NUbots/NUware/BackPanel/front.png

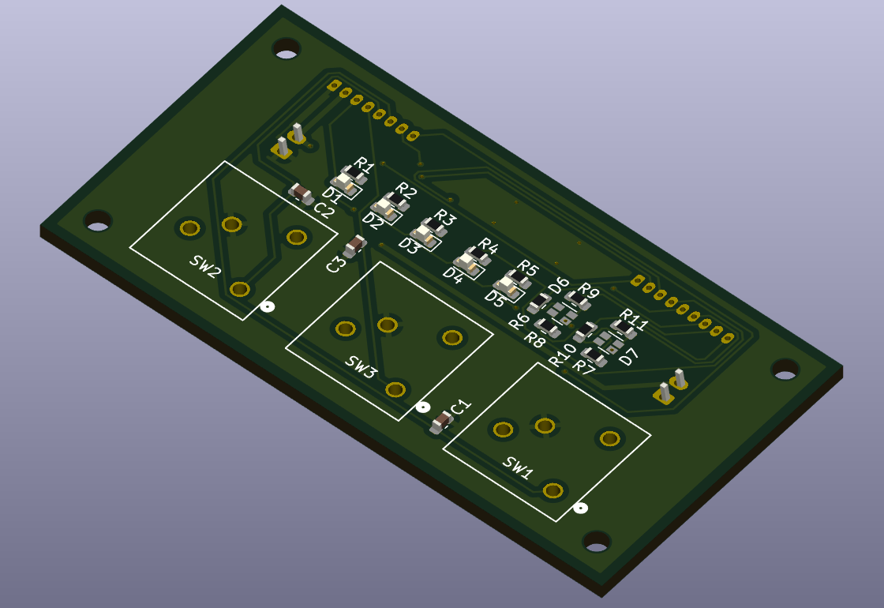
BackPanel/front.png
