NUbots/NUware/BackPanel/back.png

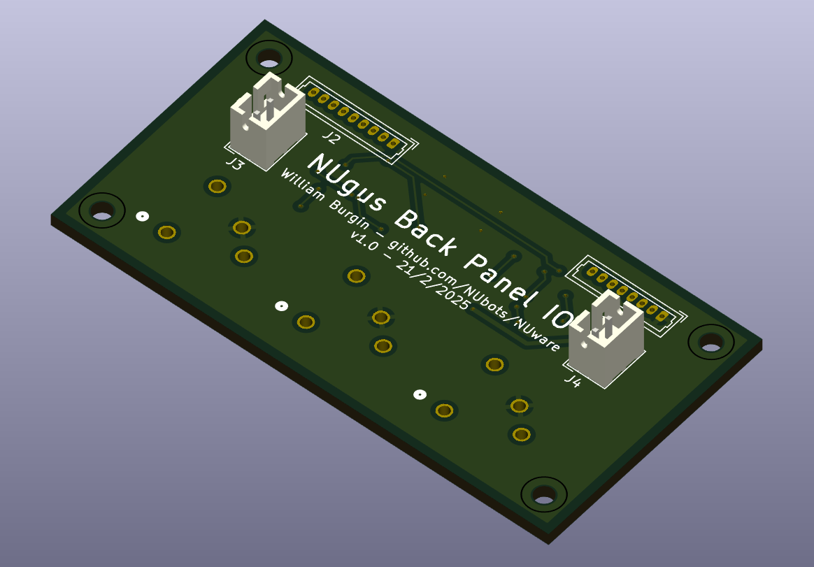
BackPanel/back.png
