NUbots/NUware/README.md

NUware
======

## Description
Hardware used by the NUbots team.
