NUbots/NUware/NUcr/NUcr.png

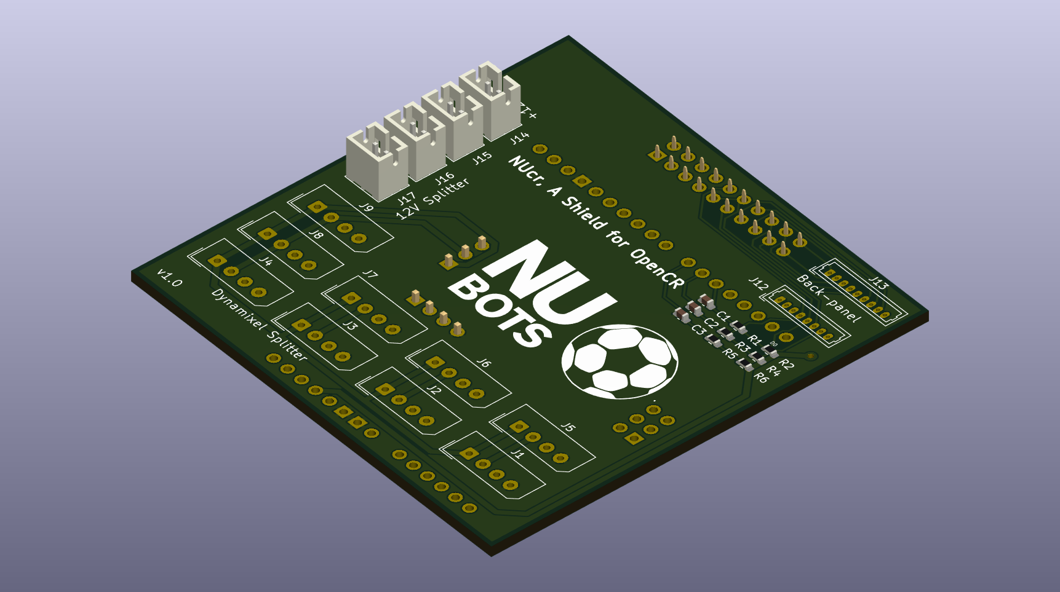
NUcr/NUcr.png
