NUbots/NUware/NUcr/resources/Ball_Black2.png

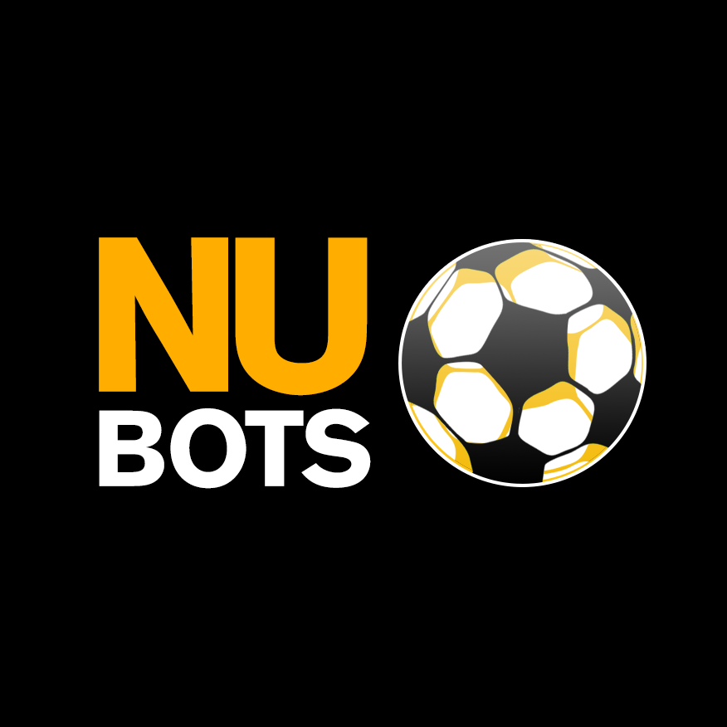
NUcr/resources/Ball_Black2.png
