NUbots/NUware/Darwin/Step Files/Darwin Foot.step

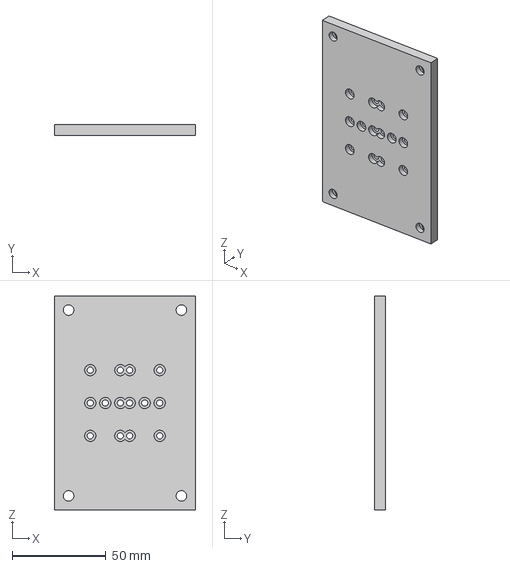
[picture p5: CAD file, 2017-06-25]
Darwin/Step Files/Darwin Foot.step
75.1 x 6.00 x 114.0 mm
