NUbots/NUware/Igus/Current Design/step_file/Flywheel_Bracket.step

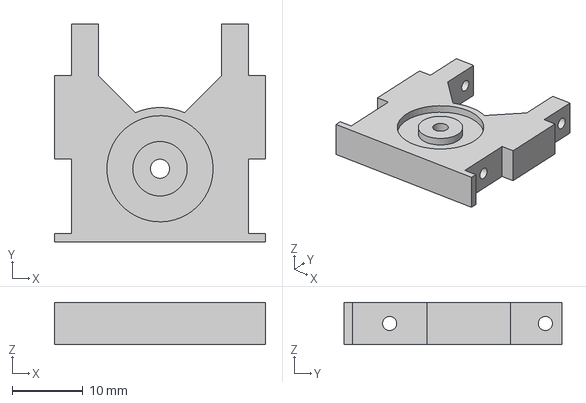
[picture p6: CAD file, 2019-11-25]
Igus/Current Design/step_file/Flywheel_Bracket.step
29.8 x 30.8 x 6.00 mm
