NUbots/NUware/Igus/Current Design/stl_file/Ankle_Block_v4/MX-106R_Ankle_Roll_Left.stl

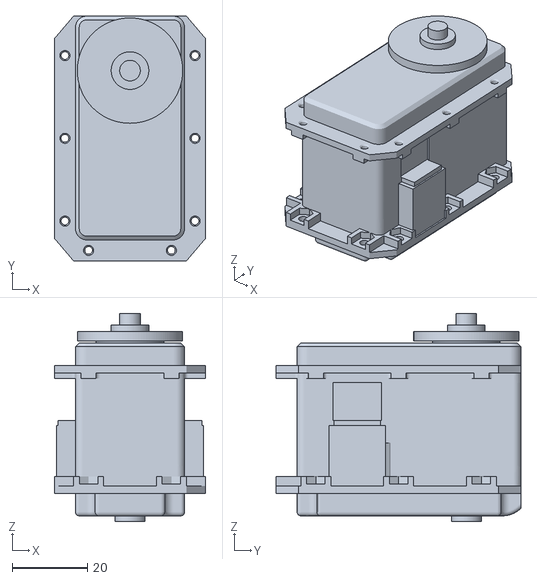
[picture p7: CAD file, 2019-04-18]
Igus/Current Design/stl_file/Ankle_Block_v4/MX-106R_Ankle_Roll_Left.stl
40.2 x 65.1 x 55.3
