NUbots/NUware/Igus/Current Design/stl_file/Arm_Lower_Left_v9/Arm_lower_bar.stl

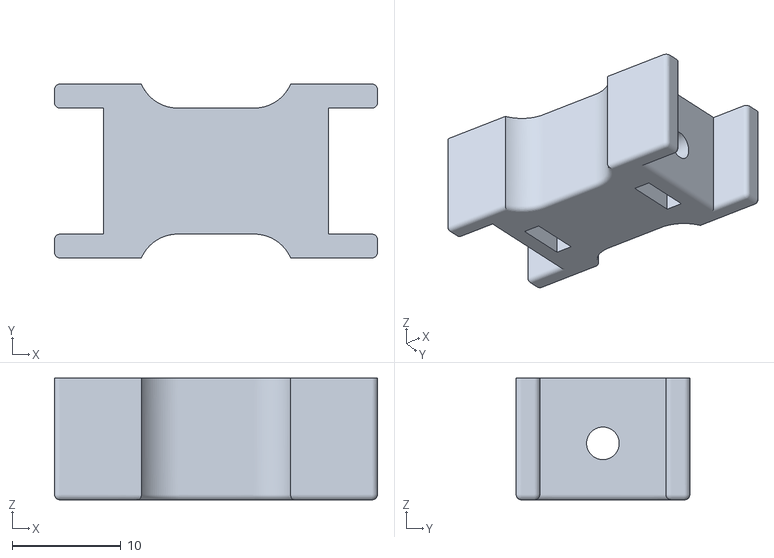
[picture p8: CAD file, 2019-04-18]
Igus/Current Design/stl_file/Arm_Lower_Left_v9/Arm_lower_bar.stl
29.7 x 16.0 x 11.2
