NUbots/NUware/Igus/Current Design/stl_file/Arm_Upper_Left_v8/MX-64AT_AR_Shoulder_Roll_Left.stl

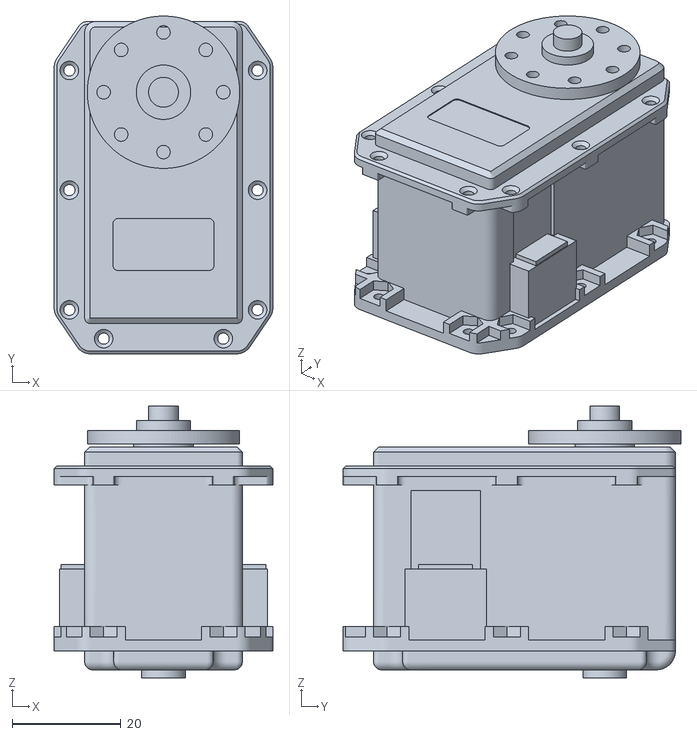
[picture p9: CAD file, 2019-04-18]
Igus/Current Design/stl_file/Arm_Upper_Left_v8/MX-64AT_AR_Shoulder_Roll_Left.stl
40.2 x 62.1 x 50.0
