NUbots/NUware/Igus/Current Design/stl_file/Foot_Left_v7/Foot.stl

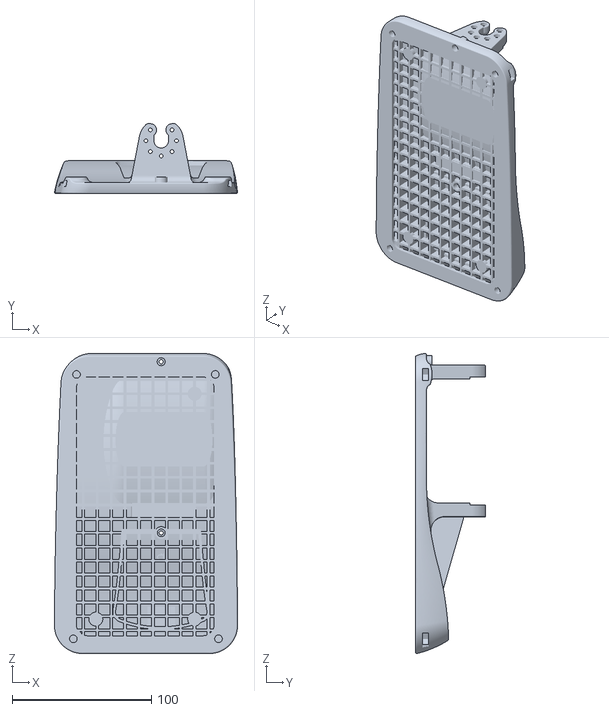
[picture p10: CAD file, 2019-04-18]
Igus/Current Design/stl_file/Foot_Left_v7/Foot.stl
131.6 x 50.5 x 215.7
