NUbots/NUware/Igus/Current Design/stl_file/Head_v9/Head_Left.stl

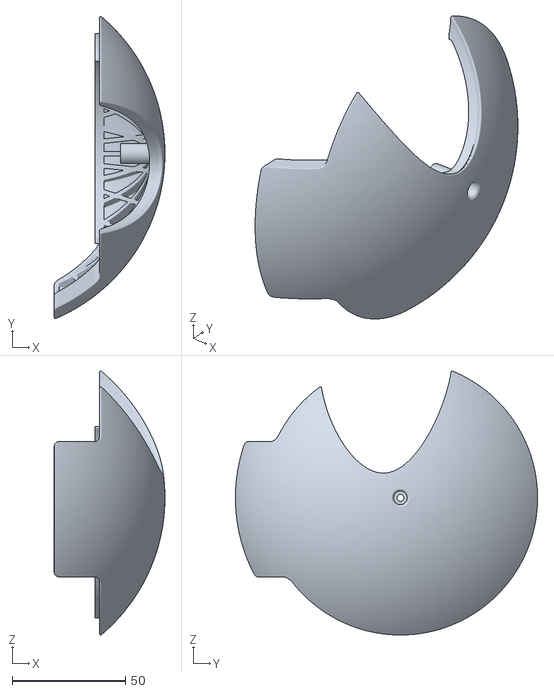
[picture p11: CAD file, 2019-04-18]
Igus/Current Design/stl_file/Head_v9/Head_Left.stl
48.7 x 133.2 x 116.3
