NUbots/NUware/Igus/Current Design/stl_file/Leg_Lower_Left_v6/Ankle_cover_left.stl

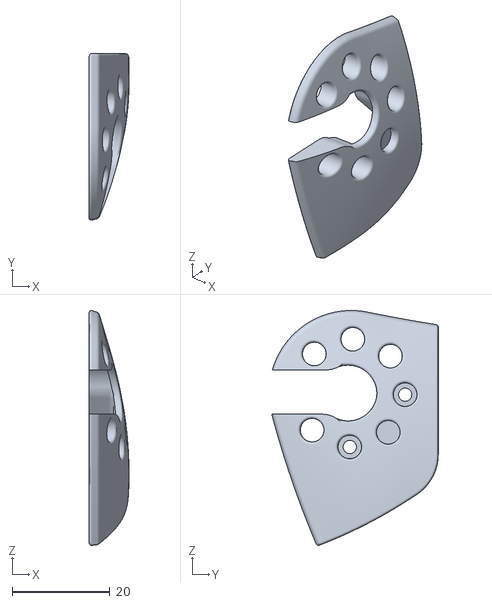
[picture p12: CAD file, 2019-04-18]
Igus/Current Design/stl_file/Leg_Lower_Left_v6/Ankle_cover_left.stl
8.17 x 34.0 x 48.0
