NUbots/NUware/Igus/Current Design/stl_file/Leg_Upper_Left_v9/Leg_upper_bar.stl

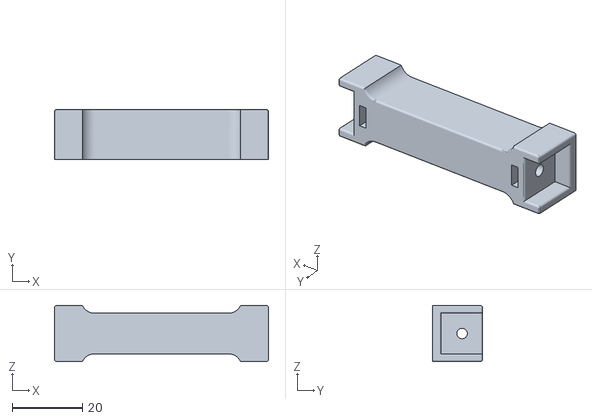
[picture p13: CAD file, 2019-04-18]
Igus/Current Design/stl_file/Leg_Upper_Left_v9/Leg_upper_bar.stl
61.0 x 14.2 x 16.0
