NUbots/NUware/Igus/Current Design/stl_file/Servo_cable_holder.stl

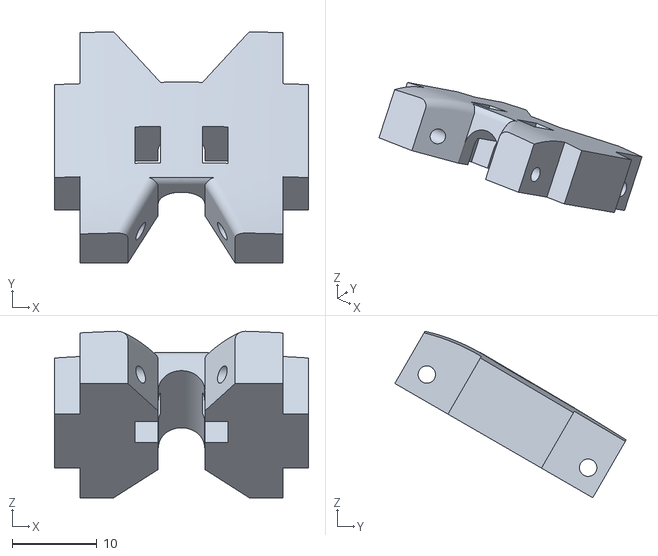
[picture p14: CAD file, 2019-11-25]
Igus/Current Design/stl_file/Servo_cable_holder.stl
30.0 x 27.3 x 19.7
