NUbots/NUware/Igus/Skins/decimated/leg_lower_left.stl

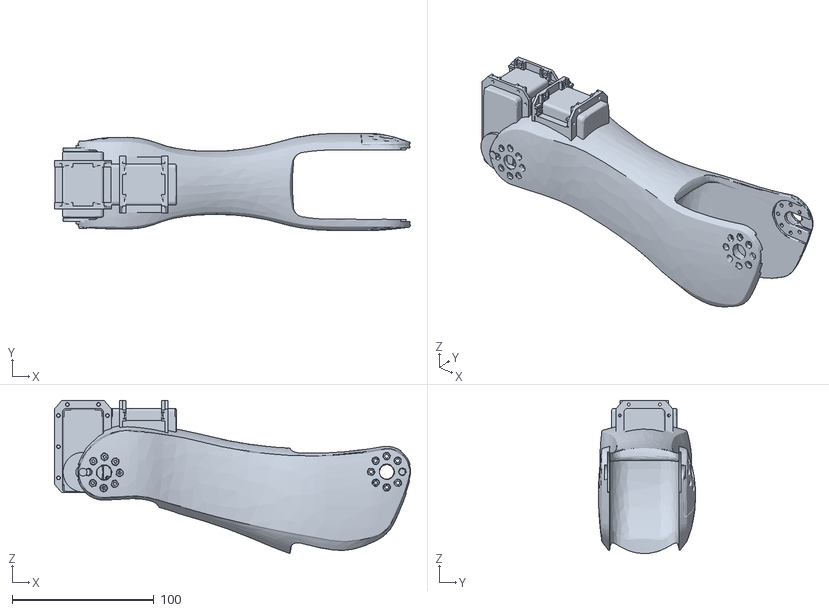
[picture p15: CAD file, 2018-10-19]
Igus/Skins/decimated/leg_lower_left.stl
251.3 x 68.6 x 108.0
