NUbots/NUware/Igus/Skins/Step Files/Arm Lower Left Skin.step

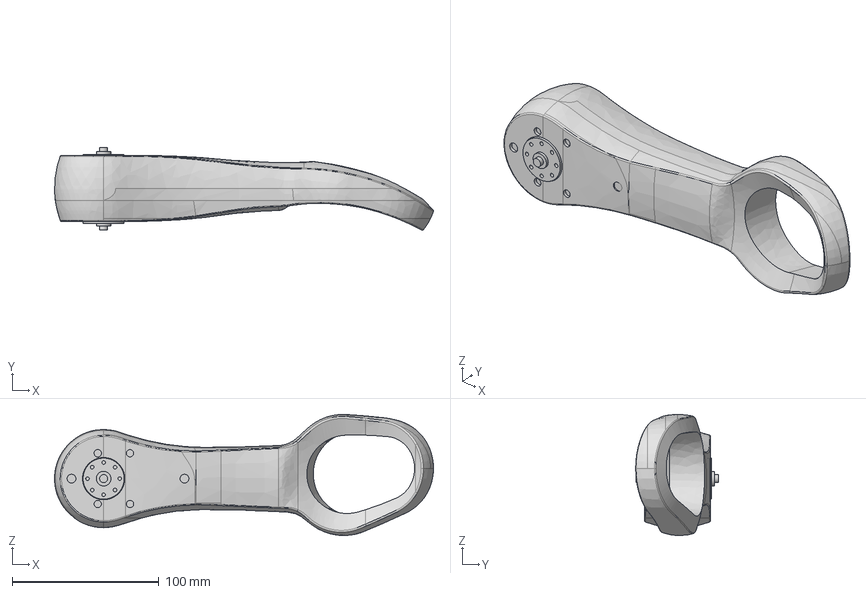
[picture p16: CAD file, 2017-06-25]
Igus/Skins/Step Files/Arm Lower Left Skin.step
258.3 x 56.3 x 82.6 mm
