NUbots/NUware/Darwin/Step Files/Darwin Stud.step

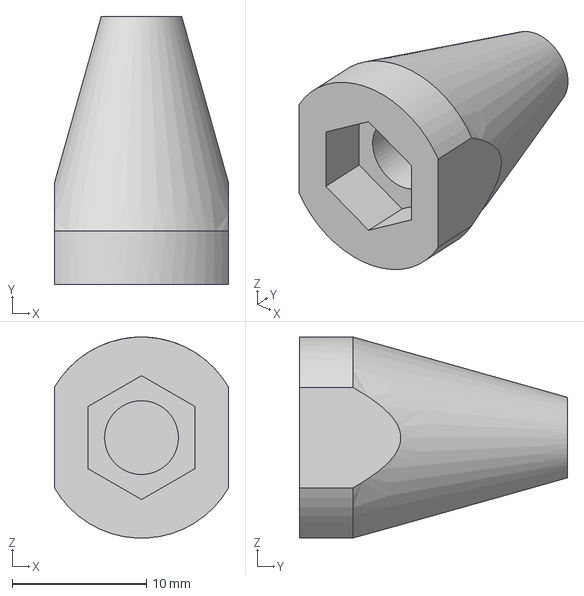
[picture p17: CAD file, 2017-06-25]
Darwin/Step Files/Darwin Stud.step
13.0 x 20.0 x 15.0 mm
