NUbots/NUware/Igus/Current Design/step_file/Head_Bracket.step

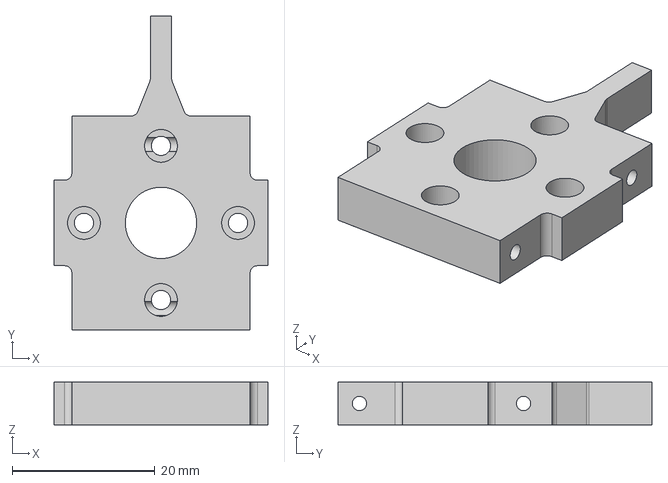
[picture p18: CAD file, 2019-11-25]
Igus/Current Design/step_file/Head_Bracket.step
30.0 x 44.0 x 6.00 mm
