NUbots/NUware/Igus/Current Design/stl_file/Arm_Upper_Left_v8/Arm_Upper_Bar_1.stl

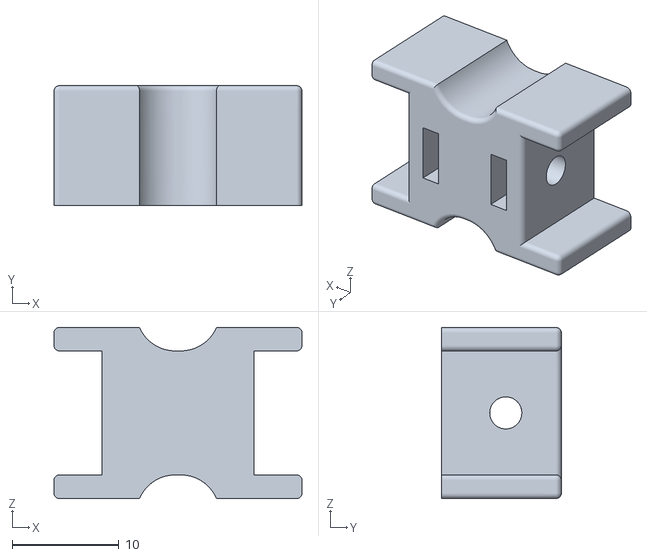
[picture p19: CAD file, 2019-04-18]
Igus/Current Design/stl_file/Arm_Upper_Left_v8/Arm_Upper_Bar_1.stl
23.2 x 11.2 x 16.0
