NUbots/NUware/Igus/Current Design/stl_file/Foot_Left_v7/Foot_heel.stl

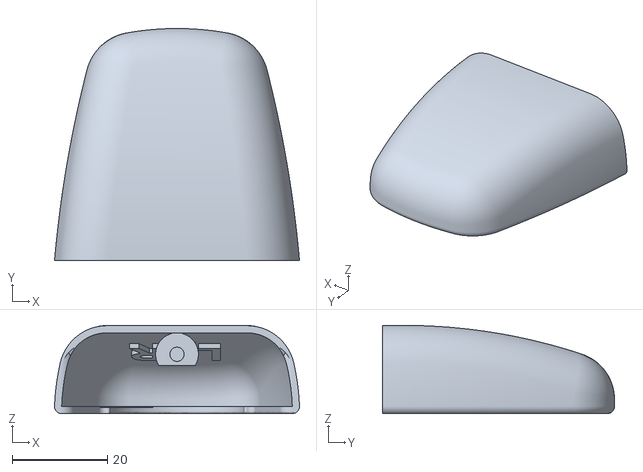
[picture p20: CAD file, 2019-04-18]
Igus/Current Design/stl_file/Foot_Left_v7/Foot_heel.stl
51.6 x 48.8 x 18.6
