NUbots/NUware/Igus/Current Design/stl_file/Head_v9/Lens_Left.stl

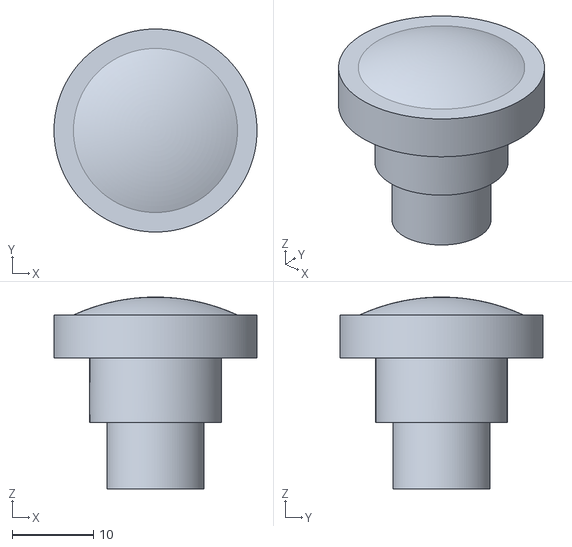
[picture p21: CAD file, 2019-04-18]
Igus/Current Design/stl_file/Head_v9/Lens_Left.stl
25.0 x 25.0 x 23.6
