NUbots/NUware/Igus/Current Design/stl_file/Leg_Lower_Left_v6/Leg_Lower_Bar.stl

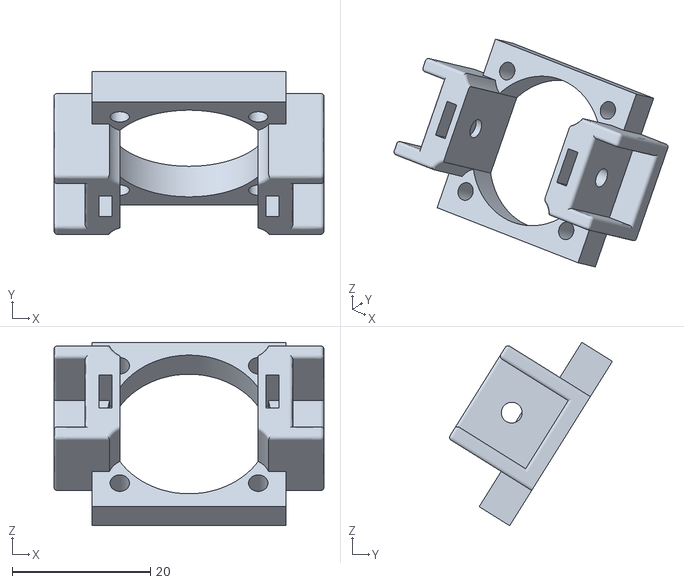
[picture p22: CAD file, 2019-04-18]
Igus/Current Design/stl_file/Leg_Lower_Left_v6/Leg_Lower_Bar.stl
39.0 x 23.5 x 26.5
