NUbots/NUware/Igus/Current Design/stl_file/Torso_v13/Shoulder_Cover_Right.stl

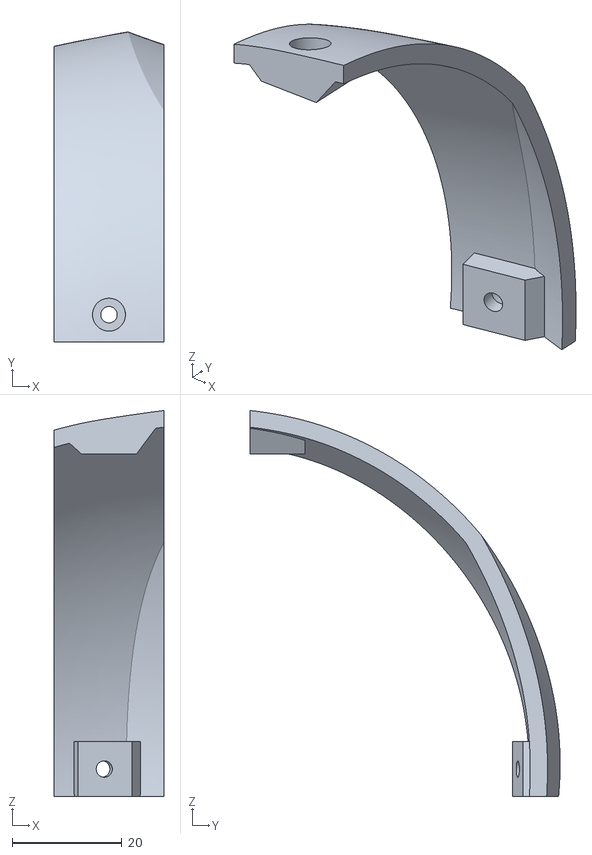
[picture p23: CAD file, 2019-04-18]
Igus/Current Design/stl_file/Torso_v13/Shoulder_Cover_Right.stl
20.0 x 56.5 x 70.4
