NUbots/NUware/Igus/Skins/decimated/servo_block.stl

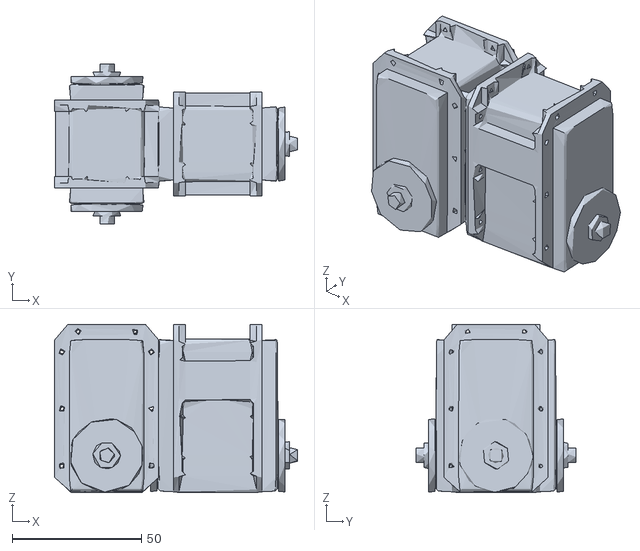
[picture p24: CAD file, 2018-10-19]
Igus/Skins/decimated/servo_block.stl
93.8 x 61.6 x 65.0
