NUbots/NUware/Igus/Skins/Step Files/Shoulder Joint Left Skin.step

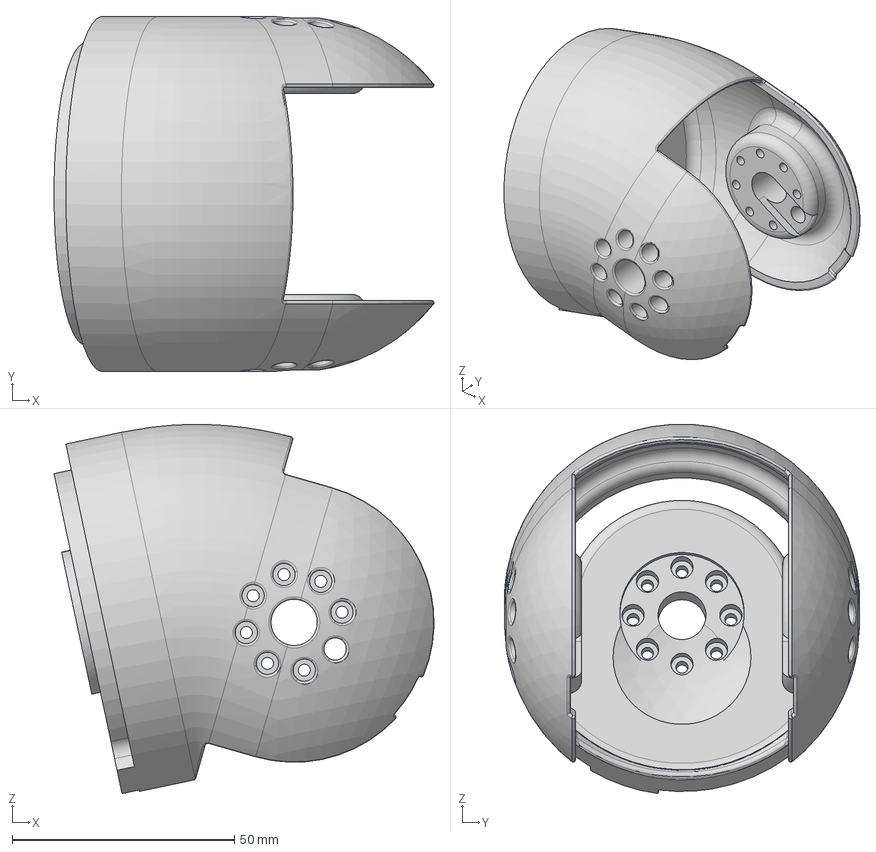
[picture p25: CAD file, 2017-06-25]
Igus/Skins/Step Files/Shoulder Joint Left Skin.step
85.5 x 80.0 x 83.1 mm
