NUbots/NUware/Igus/Current Design/step_file/Cable_Holder.step

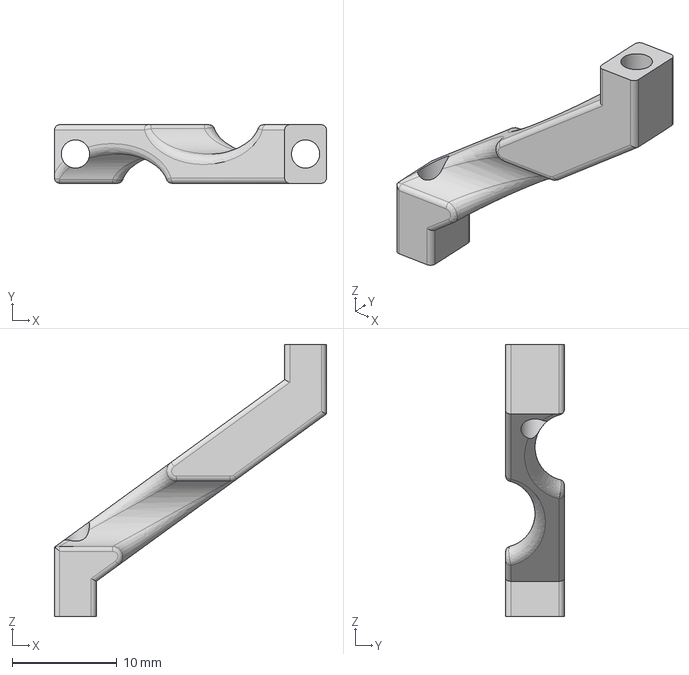
[picture p26: CAD file, 2019-11-25]
Igus/Current Design/step_file/Cable_Holder.step
26.0 x 5.60 x 26.0 mm
