NUbots/NUware/Igus/Current Design/stl_file/Arm_Lower_Left_v9/Arm_Lower_Inside_Left.stl

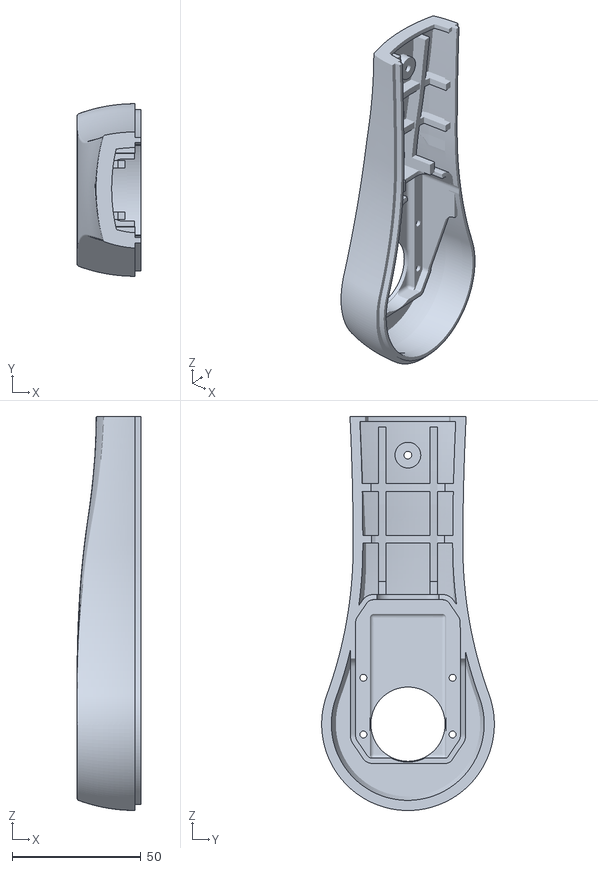
[picture p27: CAD file, 2019-04-18]
Igus/Current Design/stl_file/Arm_Lower_Left_v9/Arm_Lower_Inside_Left.stl
24.8 x 67.0 x 152.9
