NUbots/NUware/Igus/Current Design/stl_file/Arm_Upper_Left_v8/Arm_Upper_Back_Left.stl

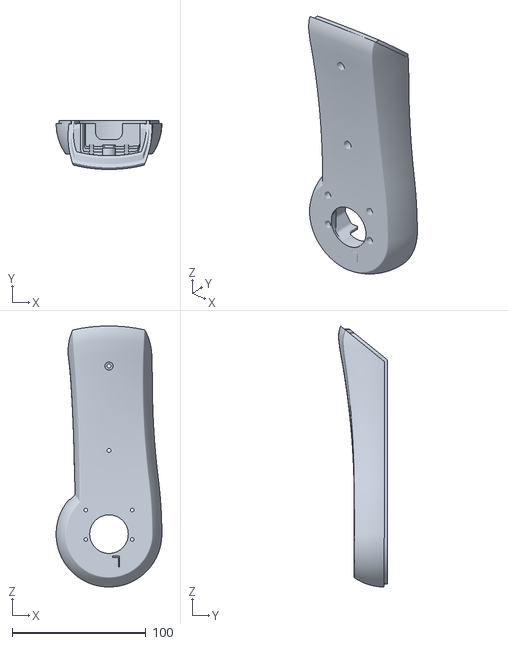
[picture p28: CAD file, 2019-04-18]
Igus/Current Design/stl_file/Arm_Upper_Left_v8/Arm_Upper_Back_Left.stl
79.0 x 36.6 x 195.0
