NUbots/NUware/Igus/Current Design/stl_file/Foot_Left_v7/Foot_toe_left.stl

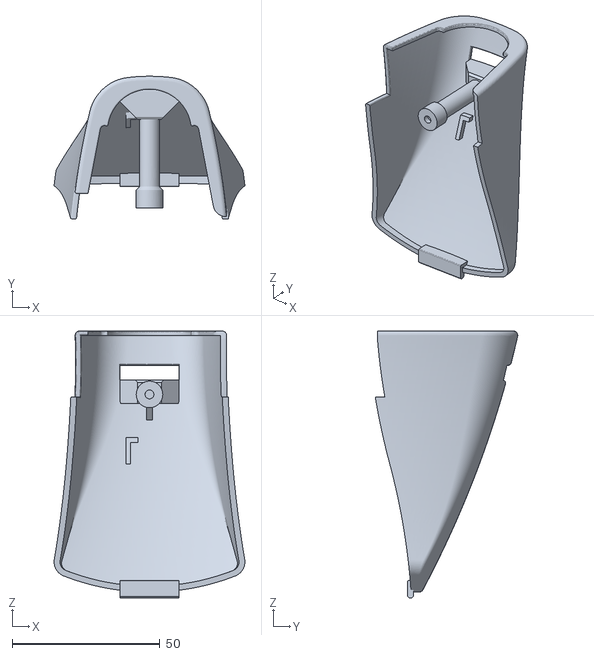
[picture p29: CAD file, 2019-04-18]
Igus/Current Design/stl_file/Foot_Left_v7/Foot_toe_left.stl
64.7 x 48.3 x 90.5
