NUbots/NUware/Igus/Current Design/stl_file/Head_v9/Head_Back.stl

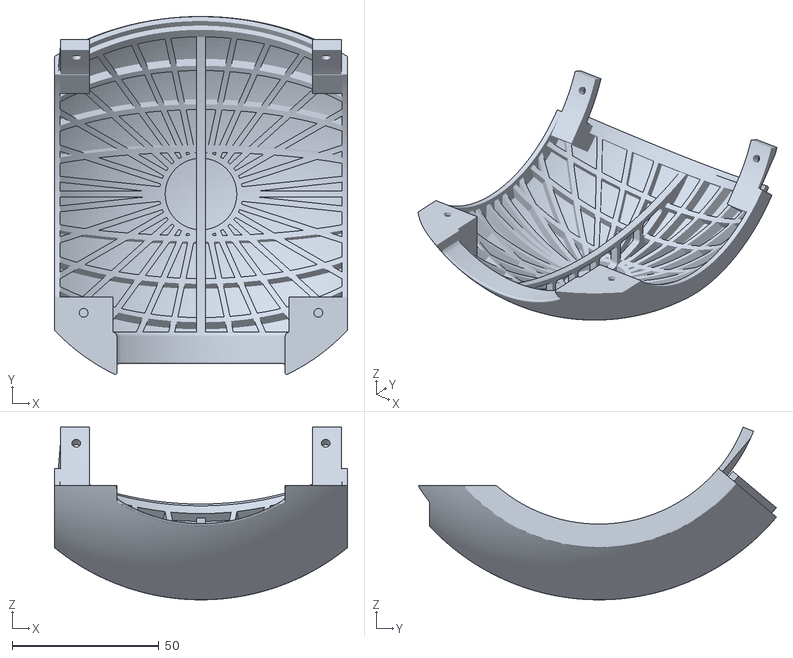
[picture p30: CAD file, 2019-04-18]
Igus/Current Design/stl_file/Head_v9/Head_Back.stl
100.0 x 122.0 x 58.9
