NUbots/NUware/Igus/Skins/decimated/Torso.stl

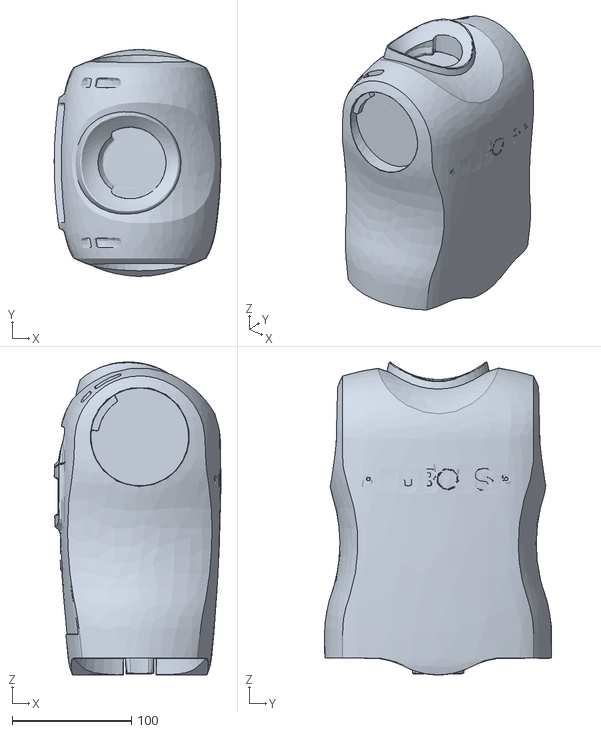
[picture p31: CAD file, 2018-10-19]
Igus/Skins/decimated/Torso.stl
139.6 x 190.0 x 262.2
