NUbots/NUware/Igus/Skins/Step Files/Head Skin.step

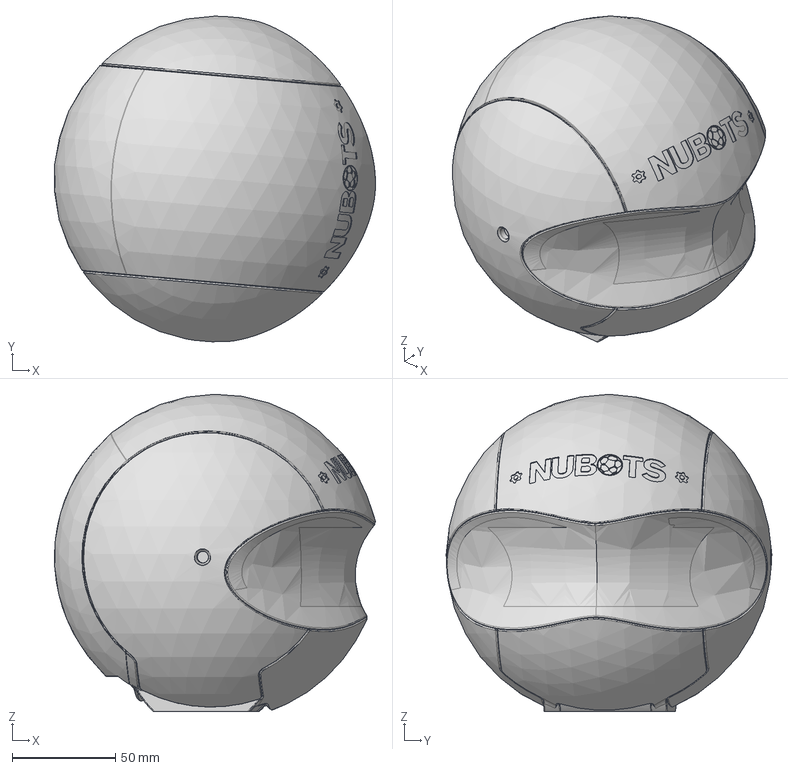
[picture p32: CAD file, 2017-06-25]
Igus/Skins/Step Files/Head Skin.step
155.7 x 157.9 x 154.0 mm
