NUbots/NUware/Igus/Current Design/step_file/Ankle_Block_v4.step

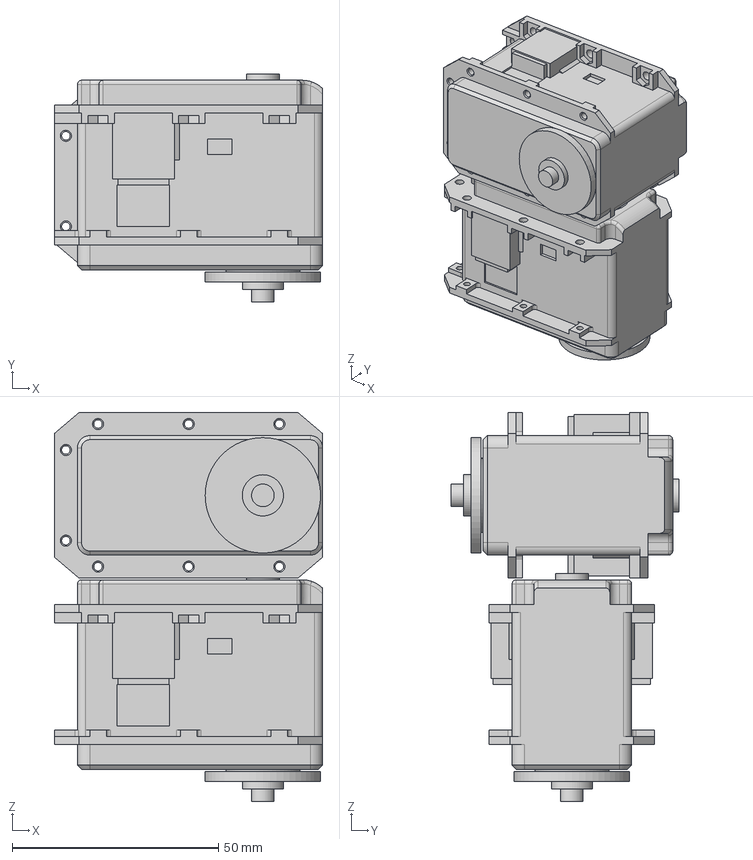
[picture p33: CAD file, 2019-04-18]
Igus/Current Design/step_file/Ankle_Block_v4.step
65.1 x 55.3 x 94.4 mm
MX-106R_Ankle_Pitch_Left
MX-106R_Ankle_Roll_Left
