NUbots/NUware/Igus/Current Design/stl_file/Arm_Lower_Left_v9/Arm_Lower_Outside_Left.stl

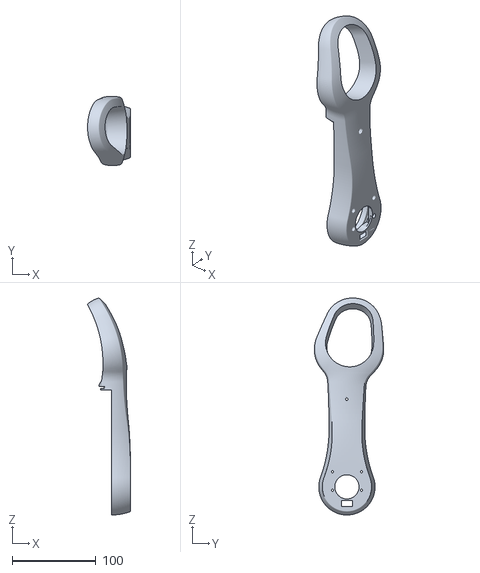
[picture p34: CAD file, 2019-04-18]
Igus/Current Design/stl_file/Arm_Lower_Left_v9/Arm_Lower_Outside_Left.stl
51.0 x 82.6 x 258.3
