NUbots/NUware/Igus/Current Design/stl_file/Arm_Upper_Left_v8/Arm_Upper_Bar_2.stl

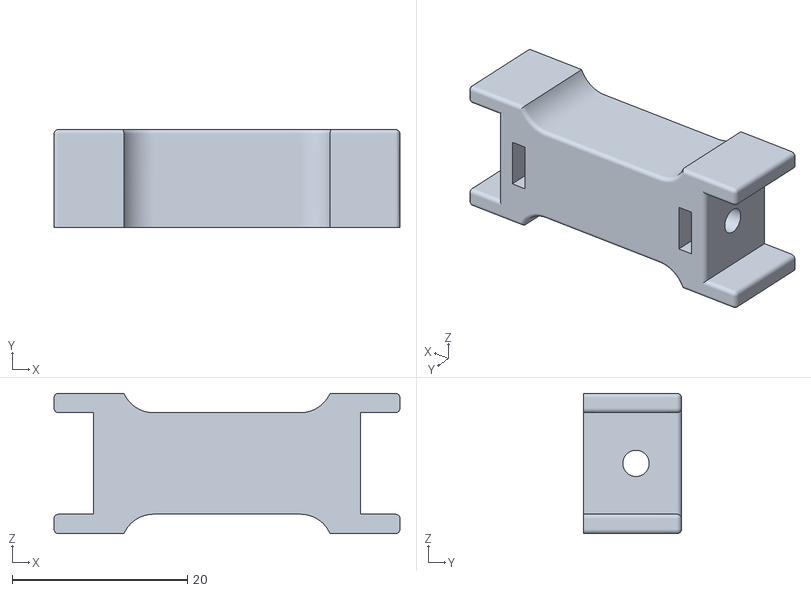
[picture p35: CAD file, 2019-04-18]
Igus/Current Design/stl_file/Arm_Upper_Left_v8/Arm_Upper_Bar_2.stl
39.5 x 11.2 x 16.0
