NUbots/NUware/Igus/Current Design/stl_file/Head_v9/CS-C_Mount_Left.stl

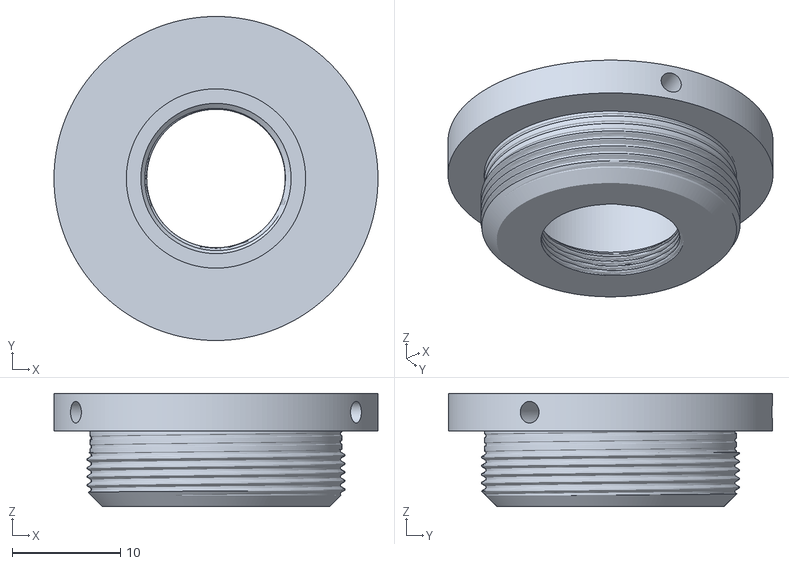
[picture p36: CAD file, 2019-04-18]
Igus/Current Design/stl_file/Head_v9/CS-C_Mount_Left.stl
30.0 x 30.0 x 10.5
