NUbots/NUware/Igus/Current Design/stl_file/Torso_v13/Speaker_Plug.stl

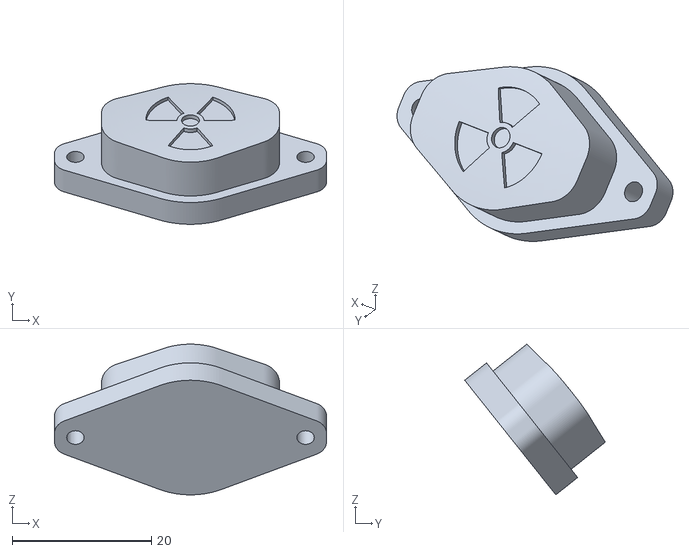
[picture p37: CAD file, 2019-04-18]
Igus/Current Design/stl_file/Torso_v13/Speaker_Plug.stl
39.0 x 20.2 x 21.6
