NUbots/NUware/Igus/Skins/Step Files/Servo Block Skin.step

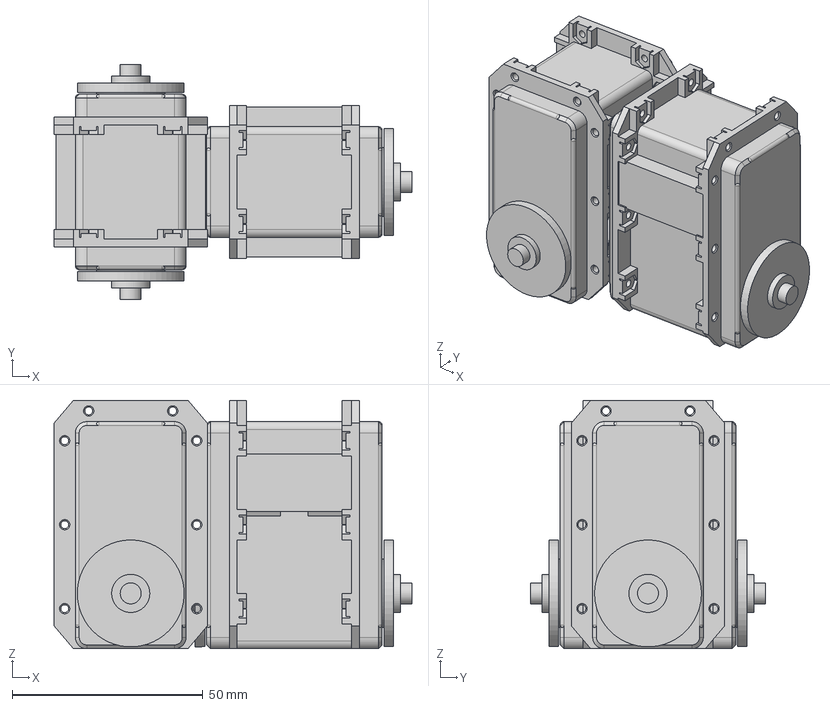
[picture p38: CAD file, 2017-06-25]
Igus/Skins/Step Files/Servo Block Skin.step
93.8 x 61.6 x 65.1 mm
