NUbots/NUware/Igus/Current Design/stl_file/Torso_v13/NUC_Shelf.stl

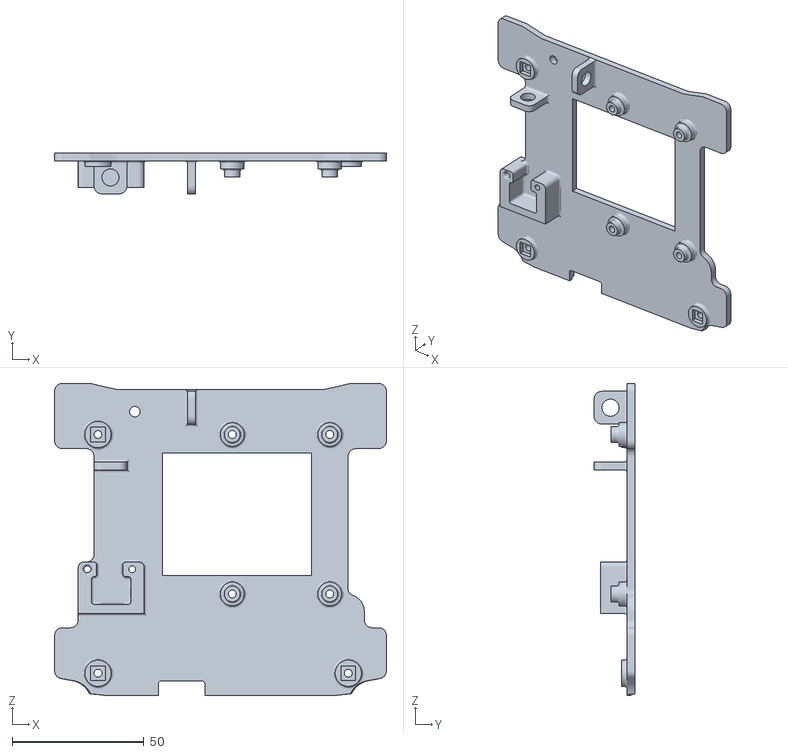
[picture p39: CAD file, 2019-04-18]
Igus/Current Design/stl_file/Torso_v13/NUC_Shelf.stl
126.0 x 15.5 x 118.5
