NUbots/NUware/Igus/Skins/Step Files/Hip Joint Left Skin.step

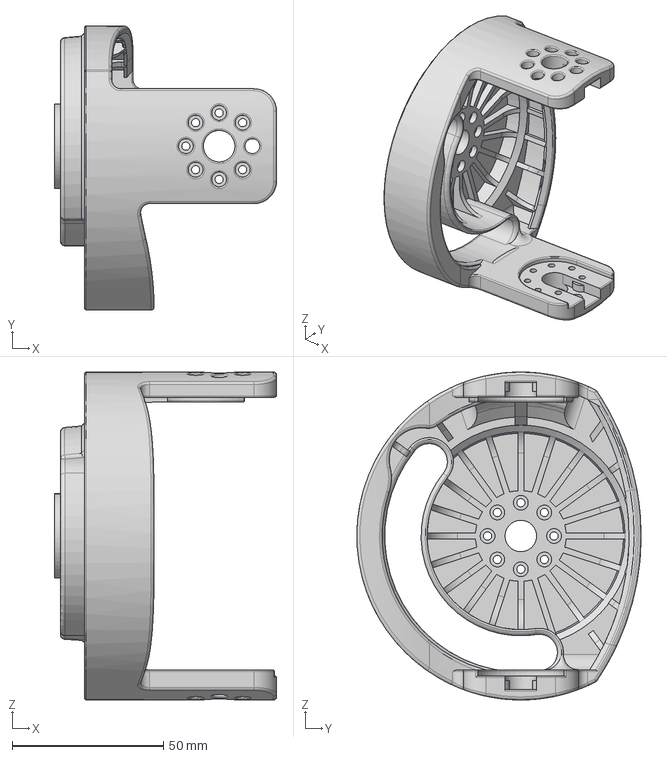
[picture p40: CAD file, 2017-06-25]
Igus/Skins/Step Files/Hip Joint Left Skin.step
73.5 x 94.0 x 108.5 mm
