NUbots/NUware/Igus/Current Design/stl_file/Head_v9/FL2-002-R6_Right.stl

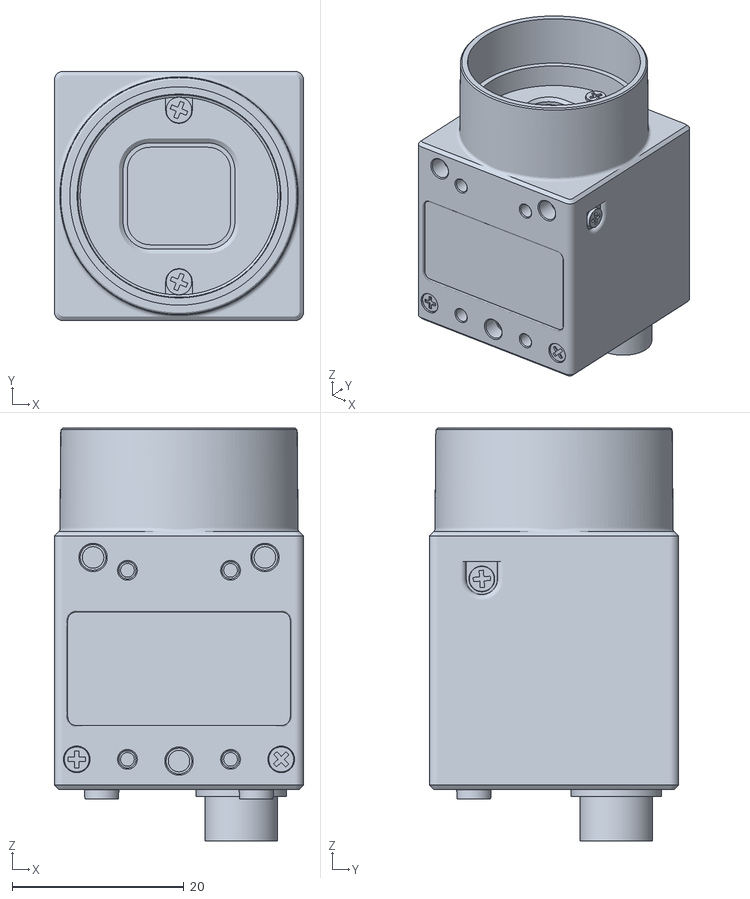
[picture p41: CAD file, 2019-04-18]
Igus/Current Design/stl_file/Head_v9/FL2-002-R6_Right.stl
29.0 x 29.0 x 48.1
