NUbots/NUware/Igus/Current Design/stl_file/Torso_v13/Top_Back_Cover.stl

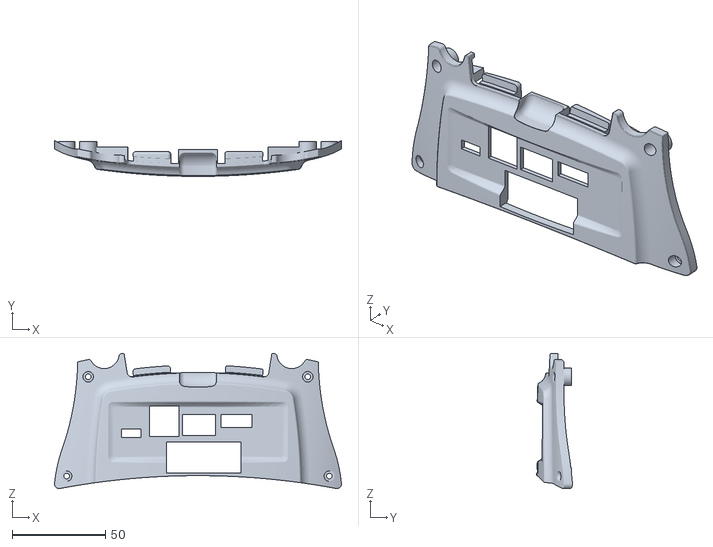
[picture p42: CAD file, 2019-04-18]
Igus/Current Design/stl_file/Torso_v13/Top_Back_Cover.stl
153.6 x 19.2 x 72.3
