NUbots/NUware/Igus/Skins/Step Files/Foot Left Skin.step

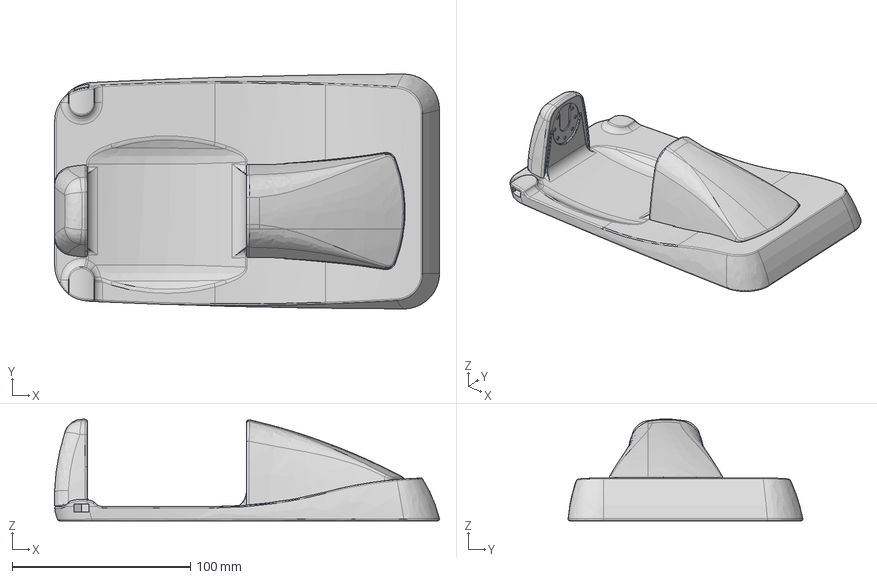
[picture p43: CAD file, 2017-06-25]
Igus/Skins/Step Files/Foot Left Skin.step
215.8 x 131.6 x 56.9 mm
