NUbots/NUware/Igus/Current Design/stl_file/Head_v9/Head_bar.stl

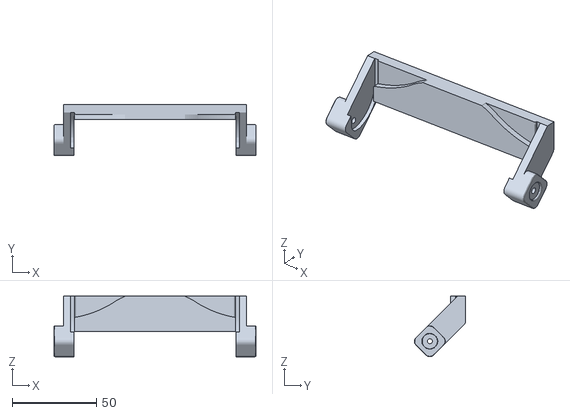
[picture p44: CAD file, 2019-04-18]
Igus/Current Design/stl_file/Head_v9/Head_bar.stl
120.0 x 30.5 x 35.9
