NUbots/NUware/Igus/Current Design/stl_file/Torso_v13/Battery.stl

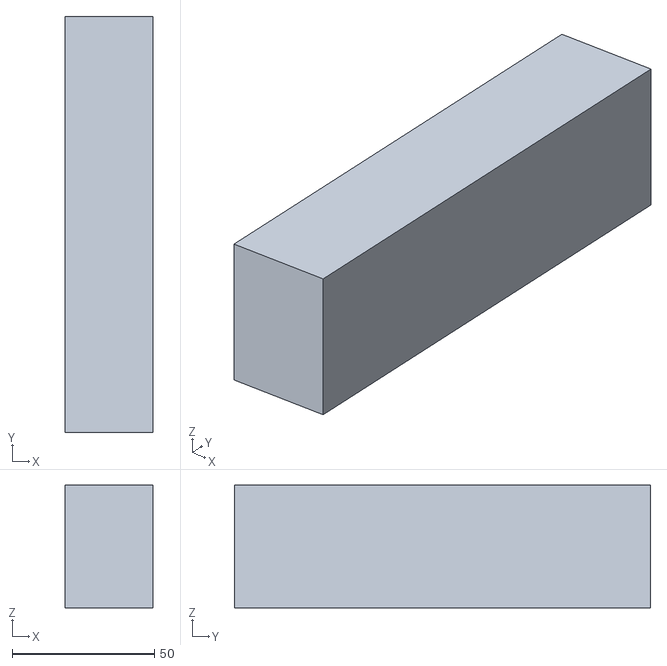
[picture p45: CAD file, 2019-04-18]
Igus/Current Design/stl_file/Torso_v13/Battery.stl
31.0 x 146.0 x 43.0
