NUbots/NUware/Igus/Current Design/stl_file/Head_v9/FaceMask.stl

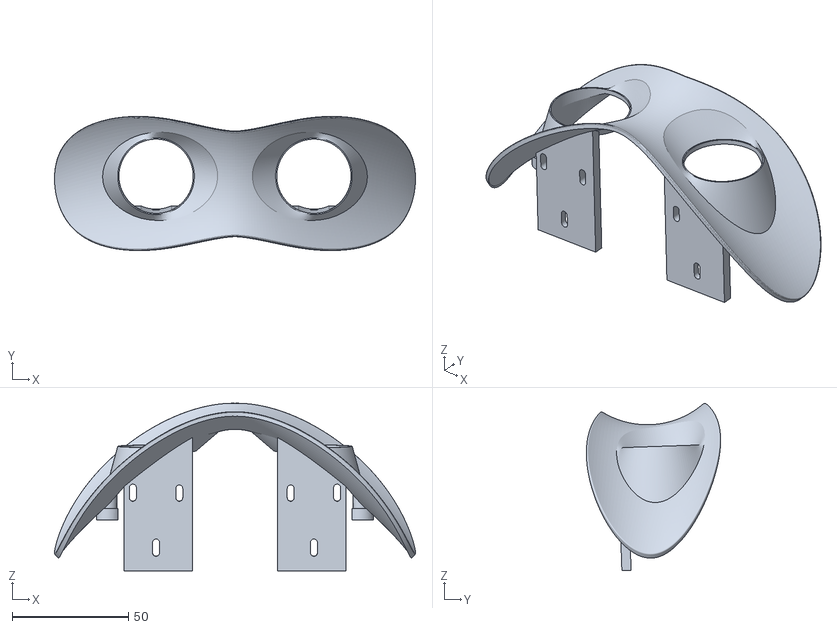
[picture p46: CAD file, 2019-04-18]
Igus/Current Design/stl_file/Head_v9/FaceMask.stl
155.5 x 57.8 x 72.2
