NUbots/NUware/Igus/Current Design/stl_file/Torso_v13/Shoulder_right.stl

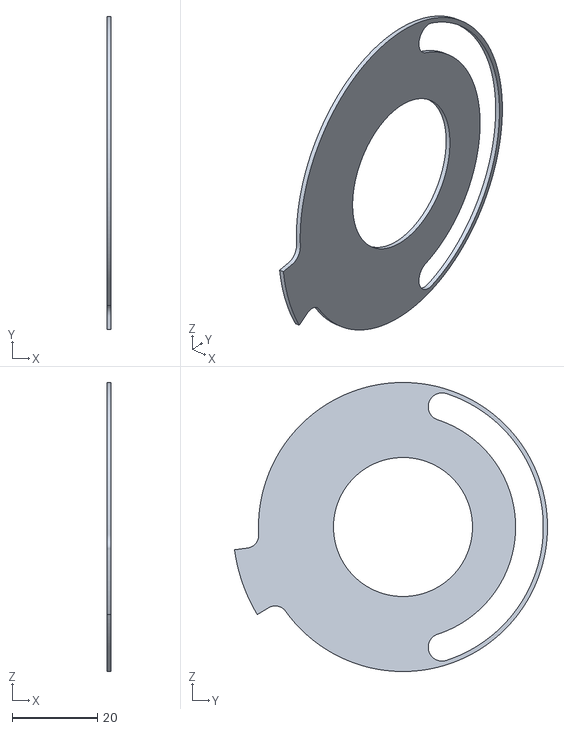
[picture p47: CAD file, 2019-04-18]
Igus/Current Design/stl_file/Torso_v13/Shoulder_right.stl
1.00 x 73.6 x 68.0
