NUbots/NUware/Igus/Current Design/stl_file/Torso_v13/Battery_Cover_Back_Plate.stl

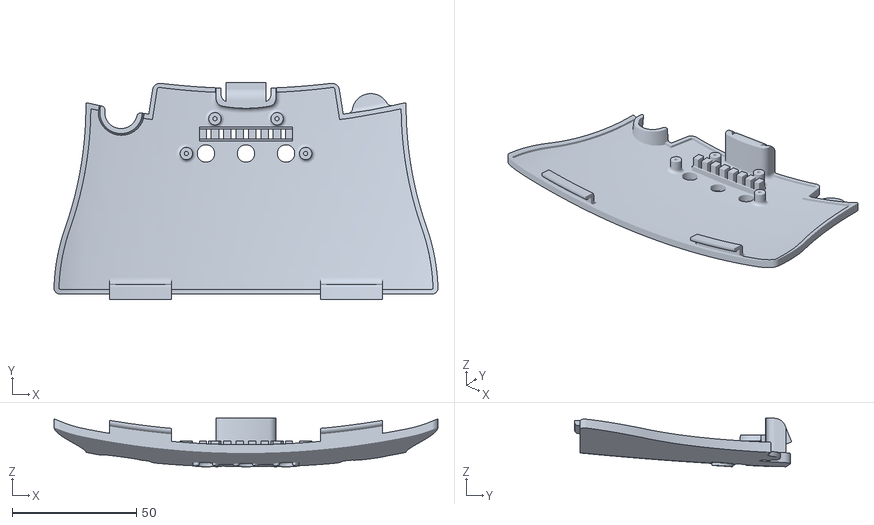
[picture p48: CAD file, 2019-04-18]
Igus/Current Design/stl_file/Torso_v13/Battery_Cover_Back_Plate.stl
154.4 x 87.2 x 19.6
