NUbots/NUware/Igus/Current Design/stl_file/Torso_v13/Handle.stl

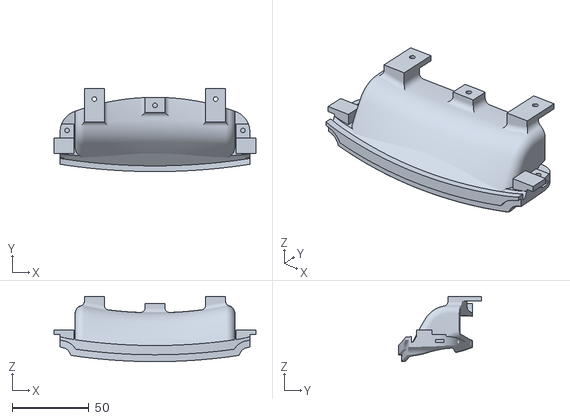
[picture p49: CAD file, 2019-04-18]
Igus/Current Design/stl_file/Torso_v13/Handle.stl
131.6 x 54.2 x 42.5
