NUbots/NUware/Igus/Current Design/stl_file/Torso_v13/Servo_support.stl

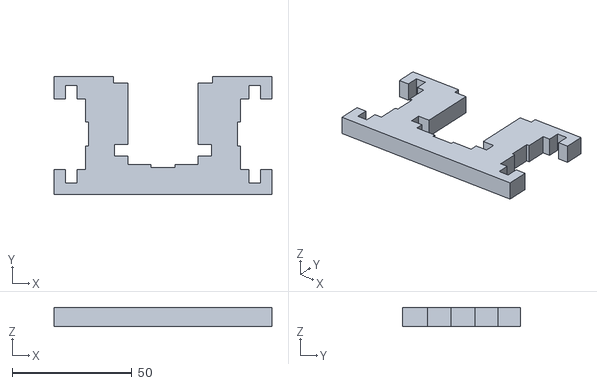
[picture p50: CAD file, 2019-04-18]
Igus/Current Design/stl_file/Torso_v13/Servo_support.stl
91.0 x 49.1 x 8.00
