NUbots/NUware/(list of files, cad)

Other CAD files:
Igus/Current Design/step_file/Hip_Block_v4.step
Igus/Skins/Step Files/Head Servo Skin.step
Igus/Current Design/stl_file/Head_v9/Head_Right.stl
Igus/Current Design/stl_file/Torso_v13/Shoulder_Cover_Left.stl
Darwin/Stl Files/Darwin Foot.stl
Darwin/Stl Files/Darwin Stud.stl
Igus/Current Design/stl_file/Cable_Holder.stl
Igus/Current Design/stl_file/Flywheel_Bracket.stl
Igus/Current Design/stl_file/Head_Bracket.stl
Igus/Skins/Stl Files/Head Servo Skin.stl
Igus/Skins/Stl Files/Servo Block Skin.stl
