NUbots/NUware/(threads)

Thread 1 (2018-12-24):

Subcontroller board from the Application Video

jgueldenstein, 2018-12-24:
Hey guys, any chance you could upload the design files for the subcontroller board from the application Video?

Jasper from the Hamburg Bit-Bots

Bidski, 2019-01-07:
Hi Jasper,

We're currently still validating that all the electronics on the board are working correctly.

Once we are confident that they are all working as intended we will start releasing more information.

For future reference, such questions can be directed to our public gitter channel at https://gitter.im/NUbots/NUbots

Closed 2019-01-07.
