NUbots/NUware/BackPanel/schematic.pdf

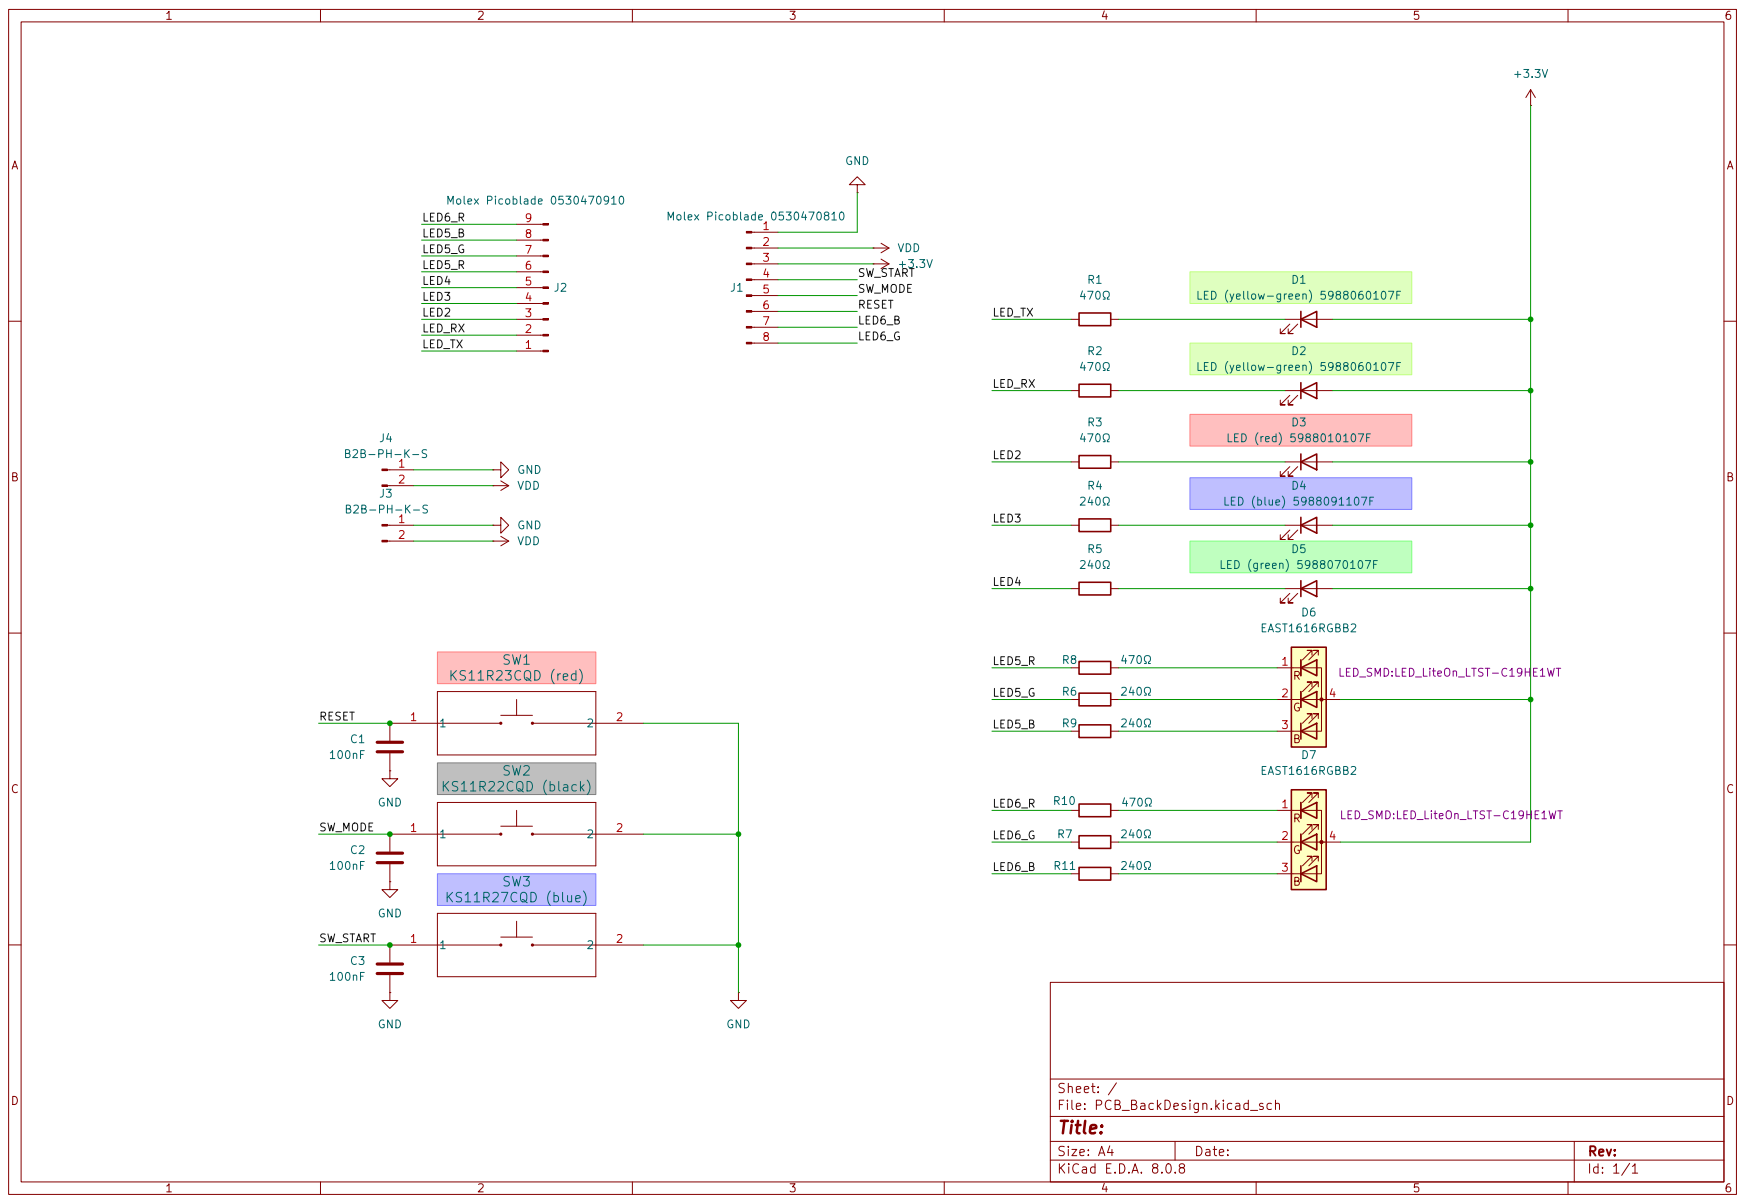
[picture p51: page 1]
