NUbots/NUware/NUcr/schematic.pdf

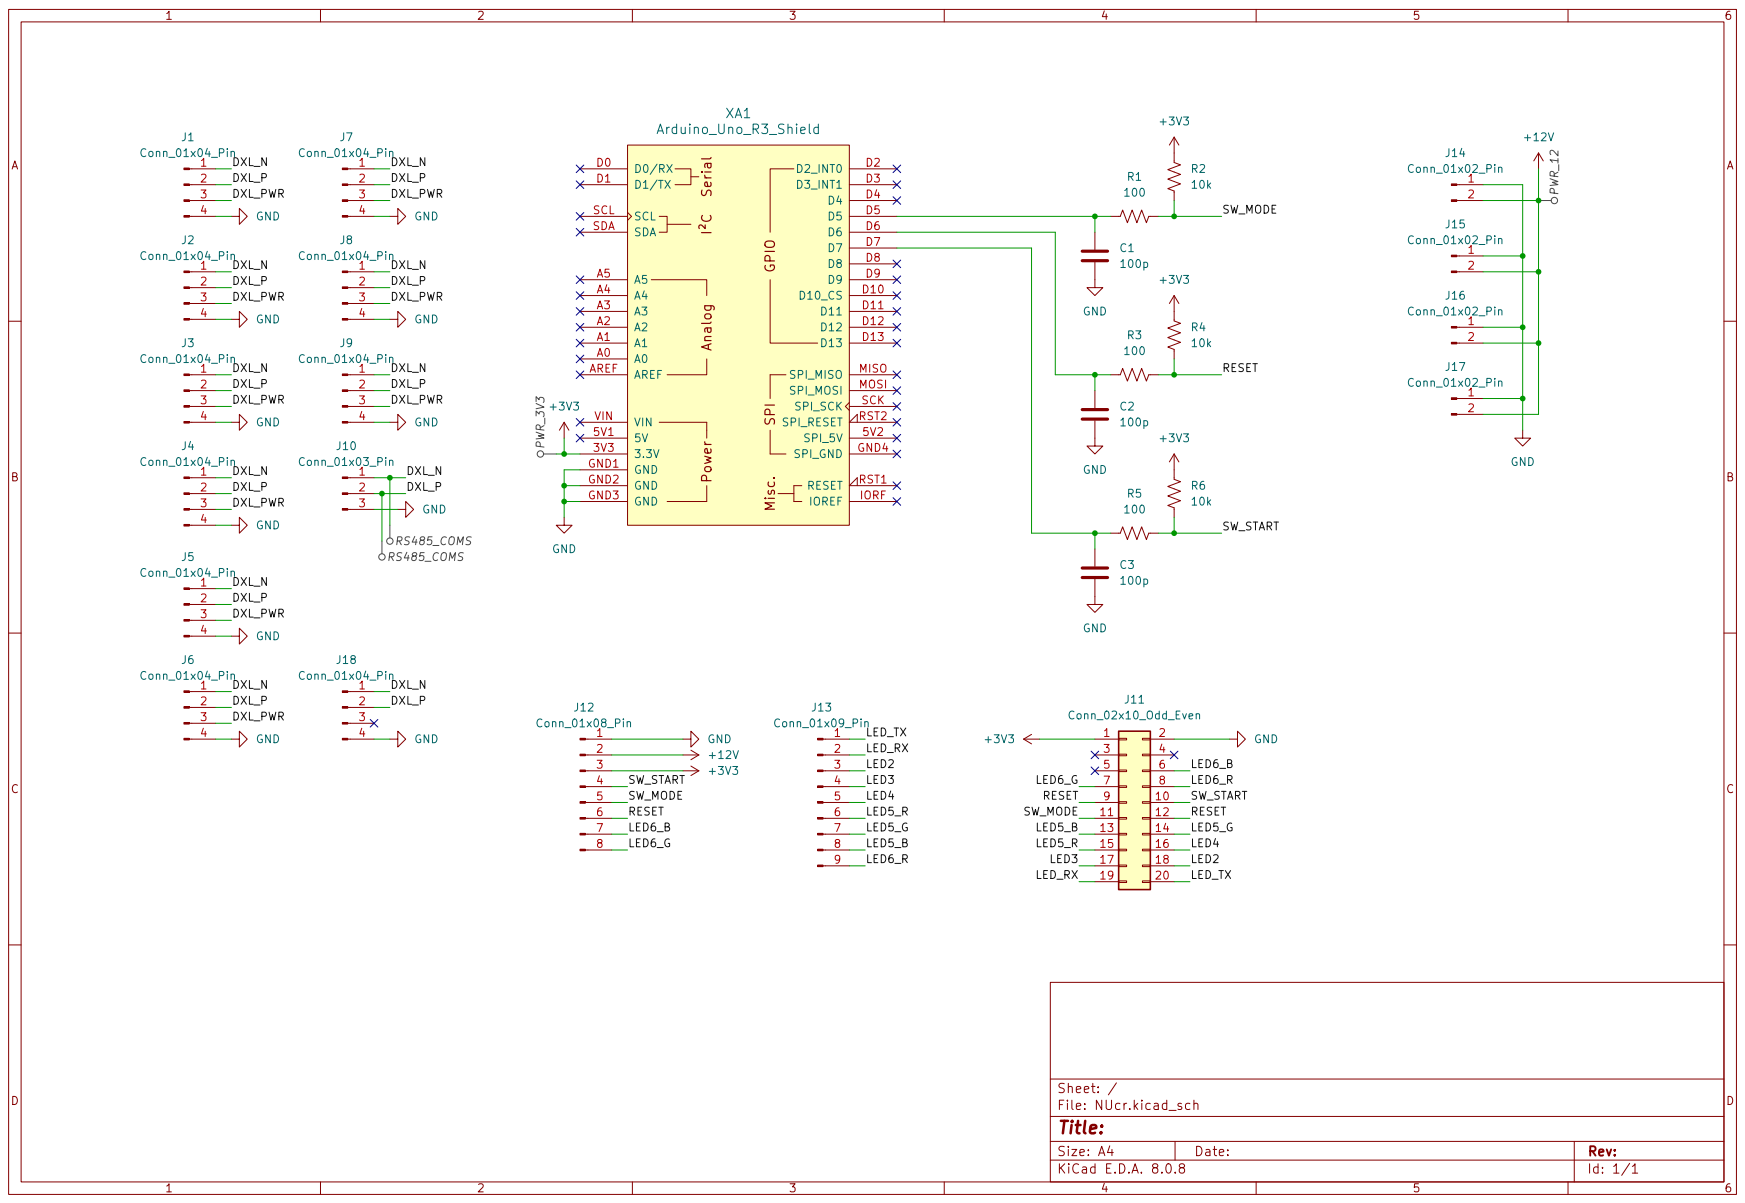
[picture p52: page 1]
