NUbots/NUware/(list of files, drawings)

Other design files:
NUFSR/nufsr-controller.schdoc
NUFSR/nufsr-fsr.schdoc
NUFSR/nufsr-motion-sensor.schdoc
NUFSR/nufsr-p00.PrjPcb
NUFSR/nufsr-power-decoupling.schdoc
NUFSR/nufsr-power.schdoc
NUFSR/nufsr-rs485.schdoc
NUFSR/nufsr-user-io.schdoc
PowerBoard/PowerBoard.PcbDoc
PowerBoard/PowerBoard.PrjPcb
PowerBoard/PowerBoard.SchDoc
