NUbots/NUware/BackPanel/PCB_BackDesign.kicad_pcb

## KiCad design BackPanel/PCB_BackDesign.kicad_pcb (2025-04-24)

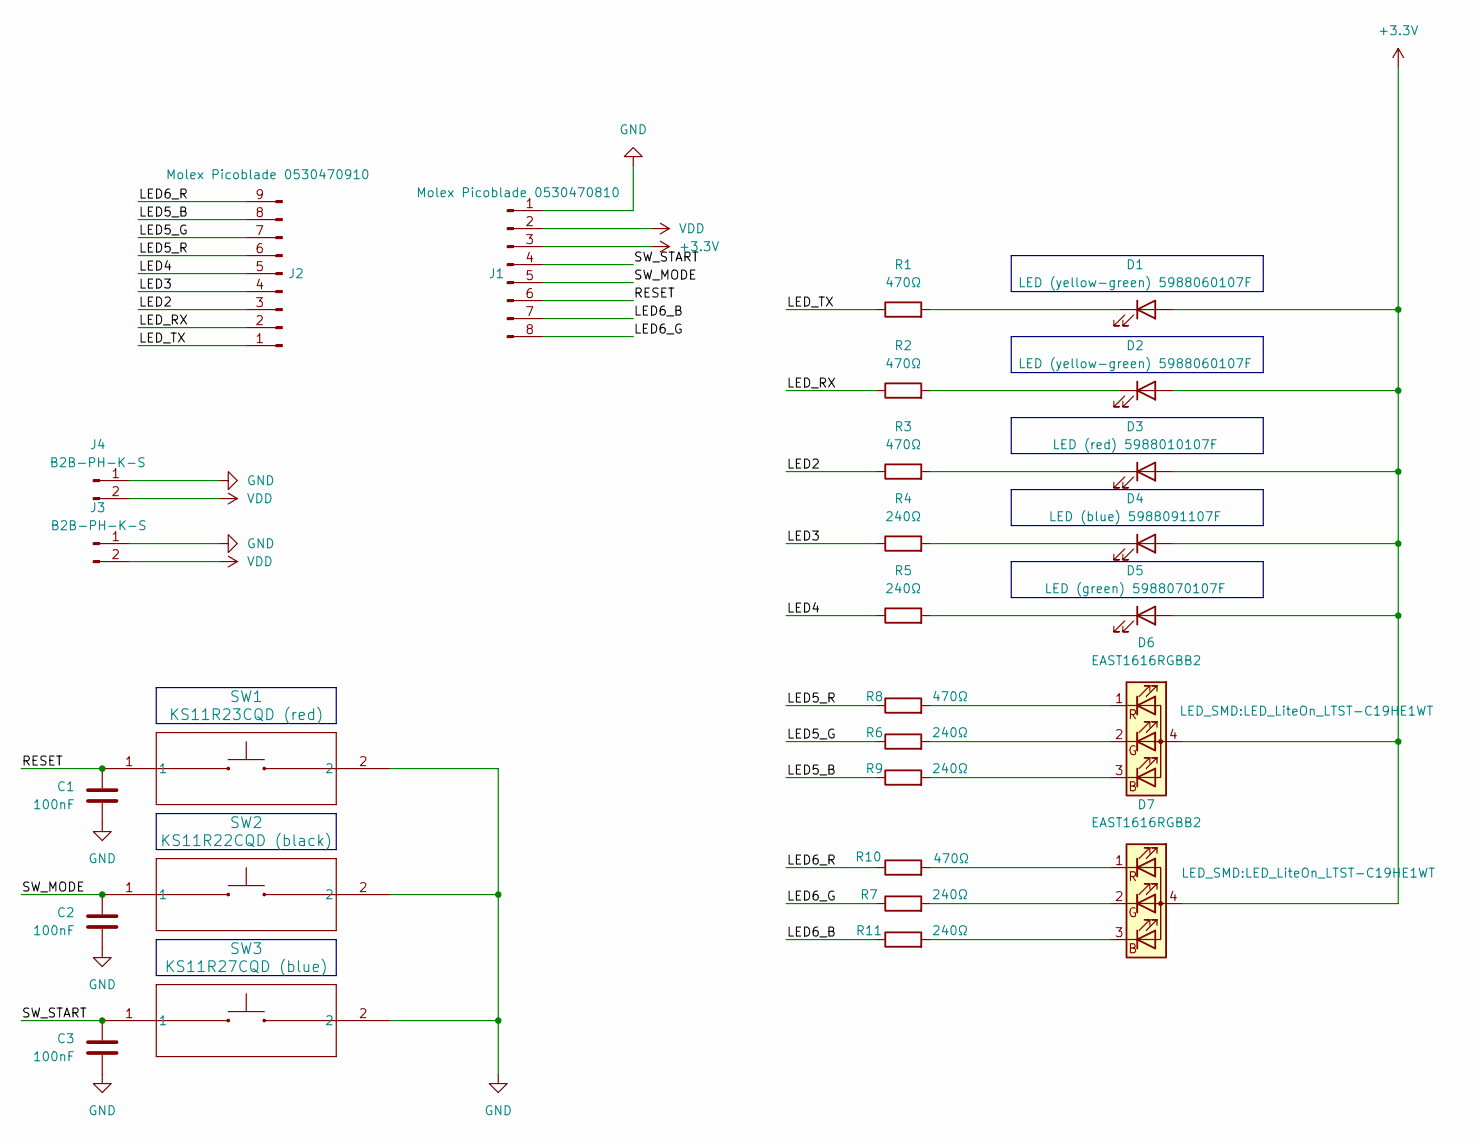
[picture p67: schematic PCB_BackDesign.kicad_sch]

Parts:
C1, C2, C3: 100nF; C_0603_1608Metric
D1, D2: LED (yellow-green) 5988060107F; LED_0603_1608Metric
D3: LED (red) 5988010107F; LED_0603_1608Metric
D4: LED (blue) 5988091107F; LED_0603_1608Metric
D5: LED (green) 5988070107F; LED_0603_1608Metric
D6, D7: EAST1616RGBB2; LED_LiteOn_LTST-C19HE1WT
J1: Molex Picoblade 0530470810; Molex_PicoBlade_53047-0810_1x08_P1.25mm_Vertical
J2: Molex Picoblade 0530470910; Molex_PicoBlade_53047-0910_1x09_P1.25mm_Vertical
J3, J4: B2B-PH-K-S; JST_PH_B2B-PH-K_1x02_P2.00mm_Vertical
R1, R2, R3, R8, R10: 470Ω; R_0603_1608Metric
R4, R5, R6, R7, R9, R11: 240Ω; R_0603_1608Metric
SW1: KS11R23CQD (red); KS11_CNK
SW2: KS11R22CQD (black); KS11_CNK
SW3: KS11R27CQD (blue); KS11_CNK

Connections:
+3.3V: D1.2 (A), D2.2 (A), D3.2 (A), D4.2 (A), D5.2 (A), D6.4 (A), D7.4 (A), J1.3
/LED2: J2.3, R3.1
/LED3: J2.4, R4.1
/LED4: J2.5, R5.1
/LED5_B: J2.8, R9.1
/LED5_G: J2.7, R6.1
/LED5_R: J2.6, R8.1
/LED6_B: J1.7, R11.1
/LED6_G: J1.8, R7.1
/LED6_R: J2.9, R10.1
/LED_RX: J2.2, R2.1
/LED_TX: J2.1, R1.1
/RESET: C1.1, J1.6, SW1.1
/SW_MODE: C2.1, J1.5, SW2.1
/SW_START: C3.1, J1.4, SW3.1
GND: C1.2, C2.2, C3.2, J1.1, J3.1, J4.1, SW1.2, SW2.2, SW3.2
unnamed: D1.1 (K), R1.2
unnamed: D2.1 (K), R2.2
unnamed: D3.1 (K), R3.2
unnamed: D4.1 (K), R4.2
unnamed: D5.1 (K), R5.2
unnamed: D6.3 (BK), R9.2
unnamed: D6.2 (GK), R6.2
unnamed: D6.1 (RK), R8.2
unnamed: D7.3 (BK), R11.2
unnamed: D7.2 (GK), R7.2
unnamed: D7.1 (RK), R10.2
VDD: J1.2, J3.2, J4.2

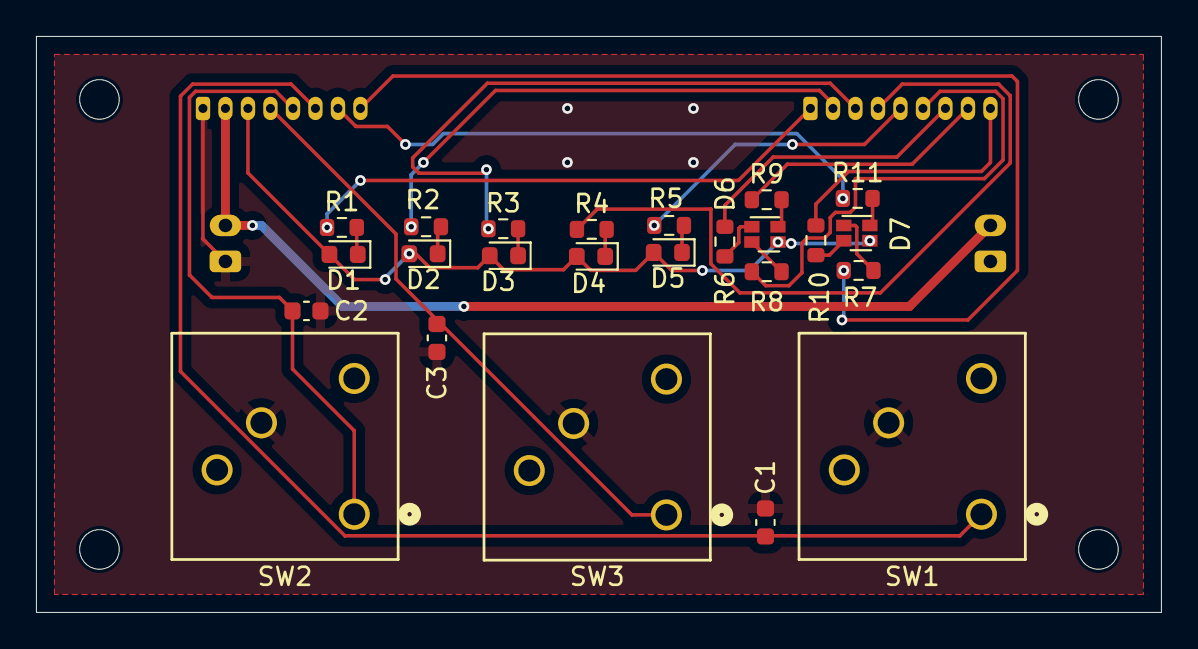
[picture p68: board PCB_BackDesign.kicad_pcb from above]

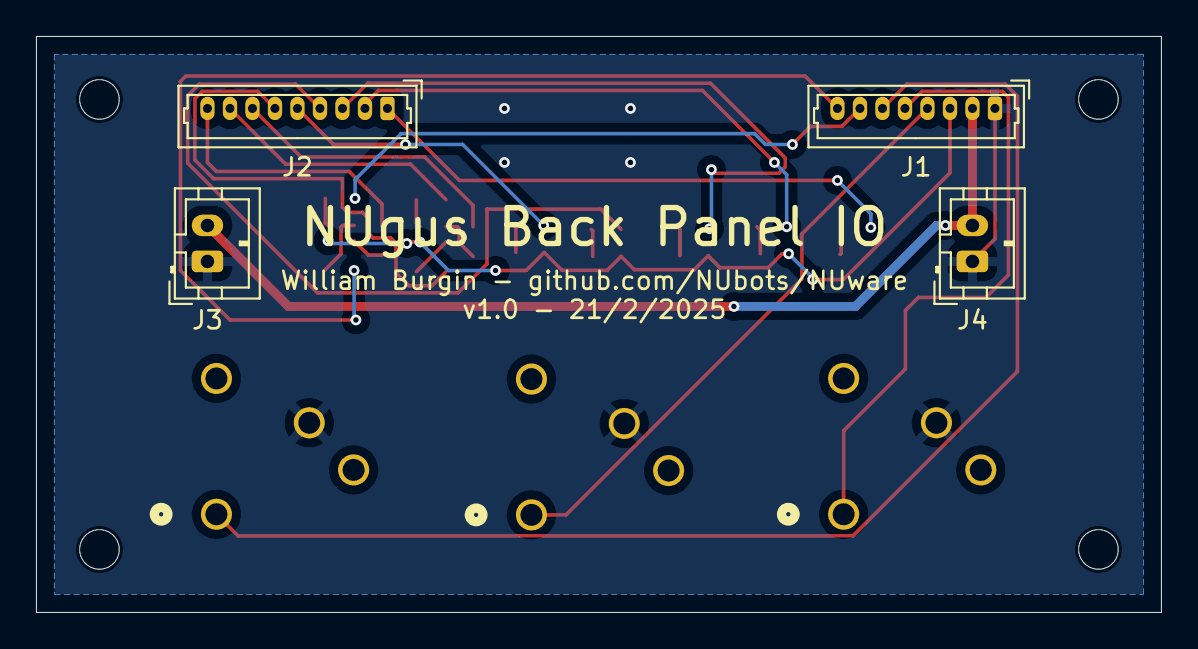
[picture p69: board PCB_BackDesign.kicad_pcb from below]

Board: 2 copper layers, 62.5 x 32.0 mm, 28 parts (4 on the bottom side), 28 nets.
