NUbots/NUware/NUcr/NUcr.kicad_pcb

## KiCad design NUcr/NUcr.kicad_pcb (2025-03-18)

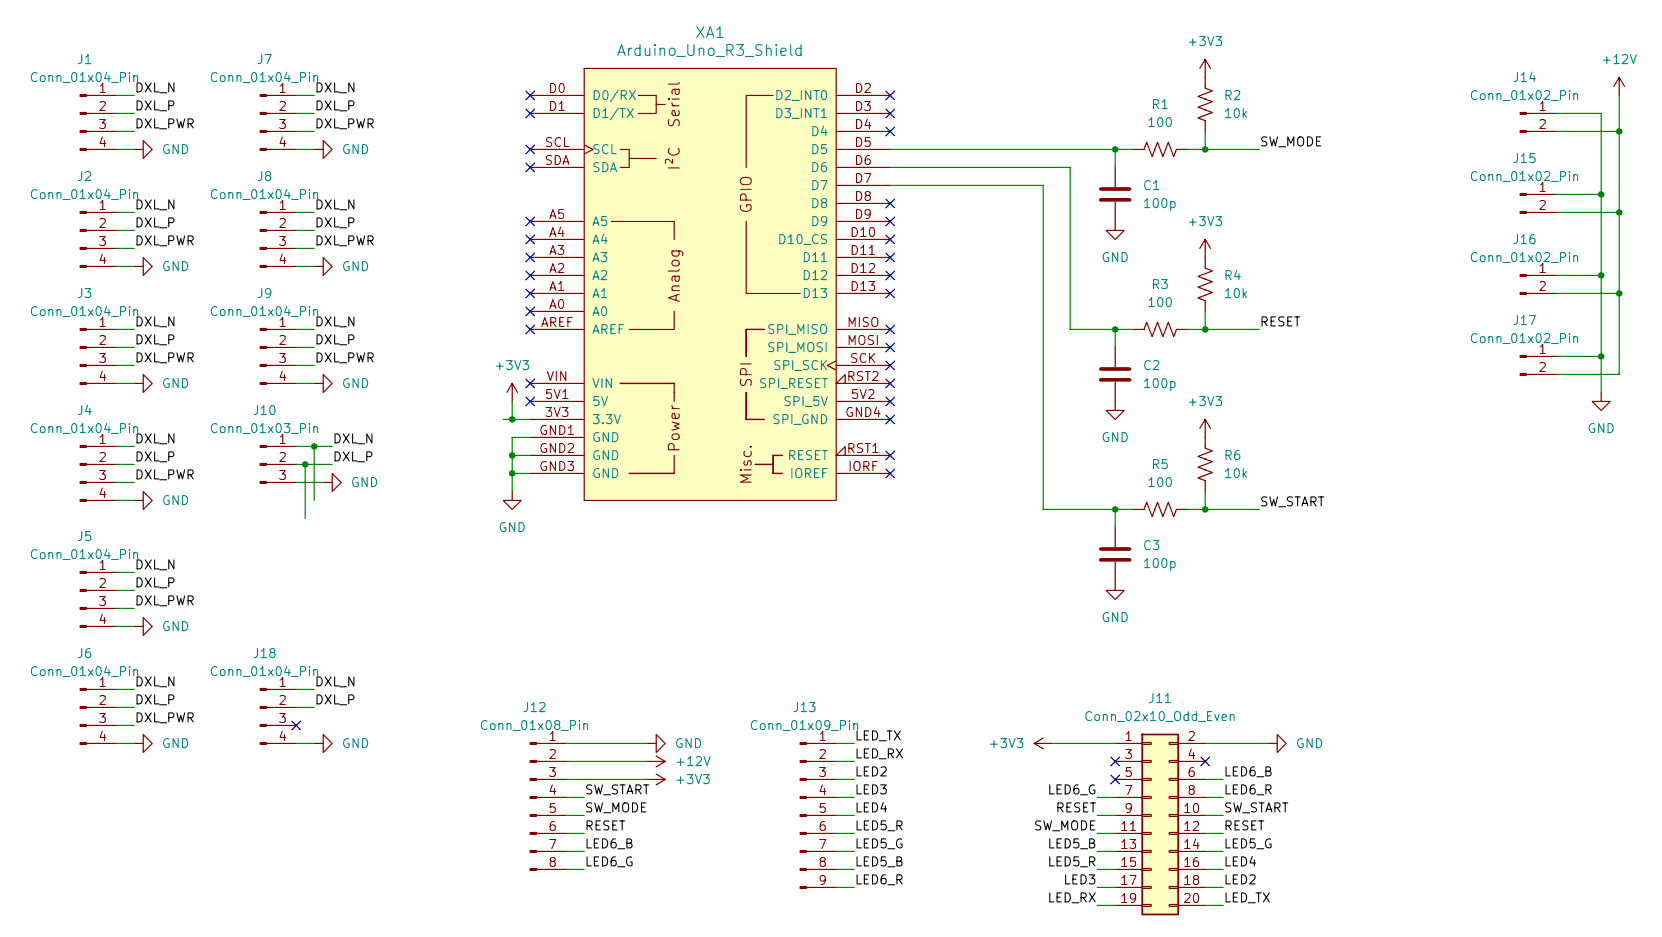
[picture p70: schematic NUcr.kicad_sch]

Parts:
C1, C2, C3: 100p; C_0603_1608Metric
J1, J2, J3, J4, J5, J6, J7, J8, J9: Conn_01x04_Pin; Molex_SPOX_5267-04A_1x04_P2.50mm_Vertical
J10: Conn_01x03_Pin; PinHeader_1x03_P2.54mm_Vertical
J11: Conn_02x10_Odd_Even; PinSocket_2x10_P2.54mm_Vertical
J12: Conn_01x08_Pin; Molex_PicoBlade_53047-0810_1x08_P1.25mm_Vertical
J13: Conn_01x09_Pin; Molex_PicoBlade_53047-0910_1x09_P1.25mm_Vertical
J14, J15, J16, J17: Conn_01x02_Pin; JST_PH_B2B-PH-K_1x02_P2.00mm_Vertical
J18: Conn_01x04_Pin; PinHeader_1x04_P2.54mm_Vertical
R1, R3, R5: 100; R_0603_1608Metric
R2, R4, R6: 10k; R_0603_1608Metric
XA1: Arduino_Uno_R3_Shield

Connections:
+3V3: J11.1, J12.3, R2.1, R4.1, R6.1, XA1.3V3 (3.3V)
+12V: J12.2, J14.2, J15.2, J16.2, J17.2
/DXL_N: J1.1, J2.1, J3.1, J4.1, J5.1, J6.1, J7.1, J8.1, J9.1, J10.1, J18.1
/DXL_P: J1.2, J2.2, J3.2, J4.2, J5.2, J6.2, J7.2, J8.2, J9.2, J10.2, J18.2
/DXL_PWR: J1.3, J2.3, J3.3, J4.3, J5.3, J6.3, J7.3, J8.3, J9.3
/LED2: J11.18, J13.3
/LED3: J11.17, J13.4
/LED4: J11.16, J13.5
/LED5_B: J11.13, J13.8
/LED5_G: J11.14, J13.7
/LED5_R: J11.15, J13.6
/LED6_B: J11.6, J12.7
/LED6_G: J11.7, J12.8
/LED6_R: J11.8, J13.9
/LED_RX: J11.19, J13.2
/LED_TX: J11.20, J13.1
/RESET: J11.9, J11.12, J12.6, R3.2, R4.2
/SW_MODE: J11.11, J12.5, R1.2, R2.2
/SW_START: J11.10, J12.4, R5.2, R6.2
GND: C1.2, C2.2, C3.2, J1.4, J2.4, J3.4, J4.4, J5.4, J6.4, J7.4, J8.4, J9.4, J10.3, J11.2, J12.1, J14.1, J15.1, J16.1, J17.1, J18.4, XA1.GND1 (GND), XA1.GND2 (GND), XA1.GND3 (GND)
unnamed: C1.1, R1.1, XA1.D5
unnamed: C2.1, R3.1, XA1.D6
unnamed: C3.1, R5.1, XA1.D7

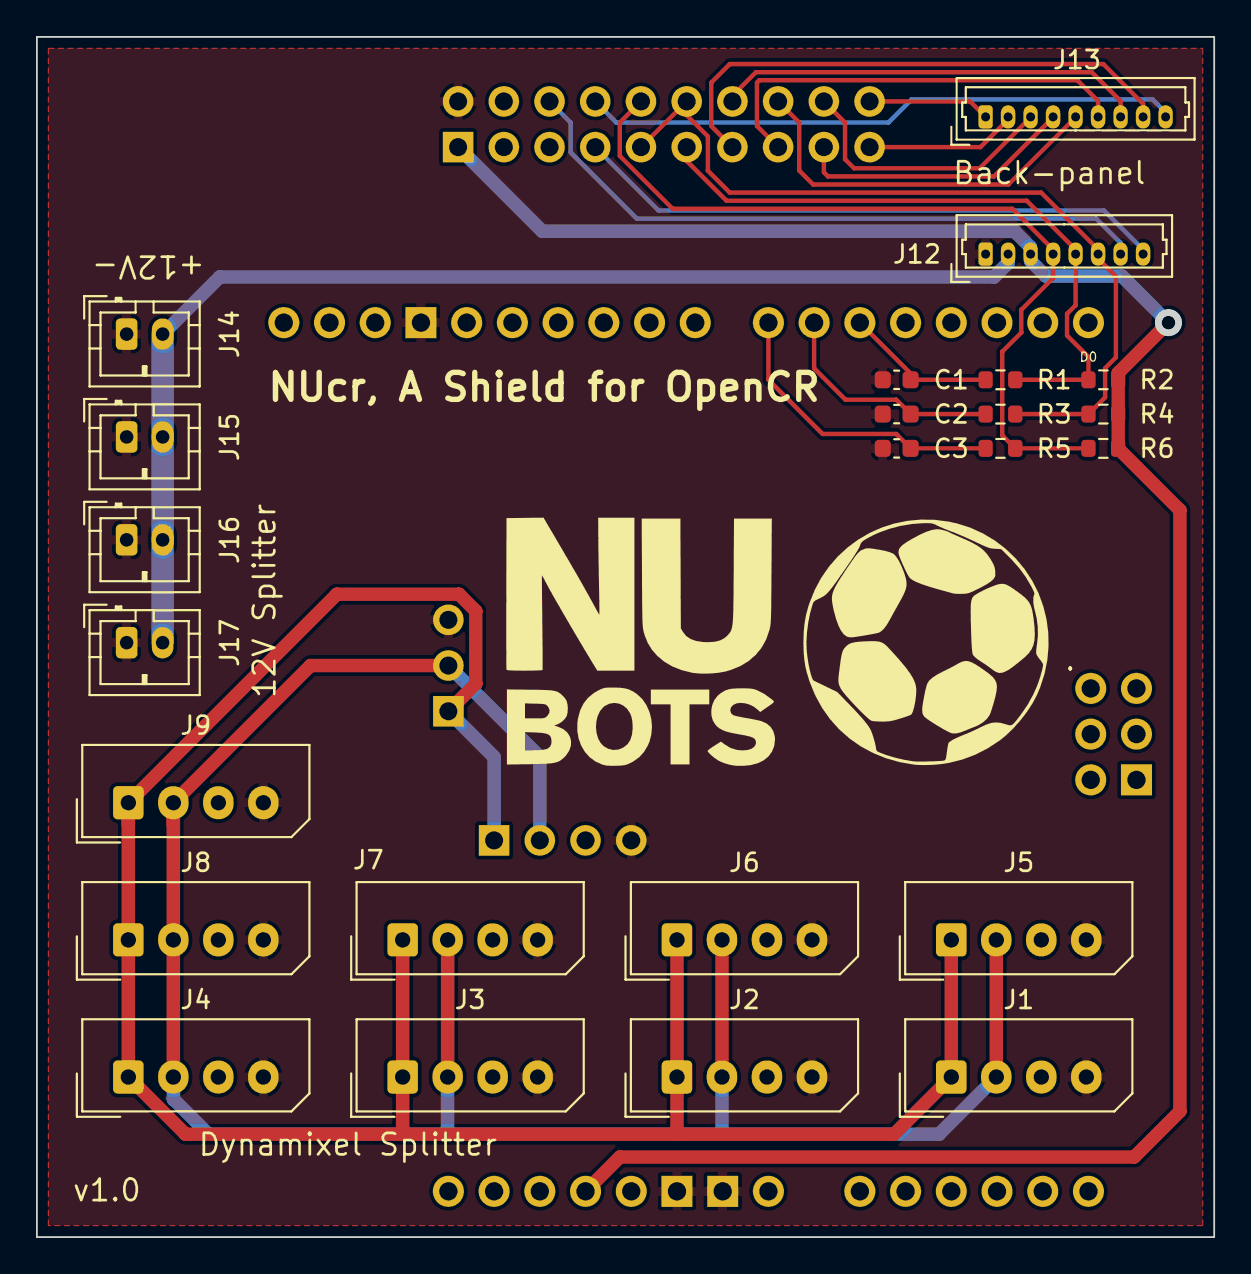
[picture p71: board NUcr.kicad_pcb from above]

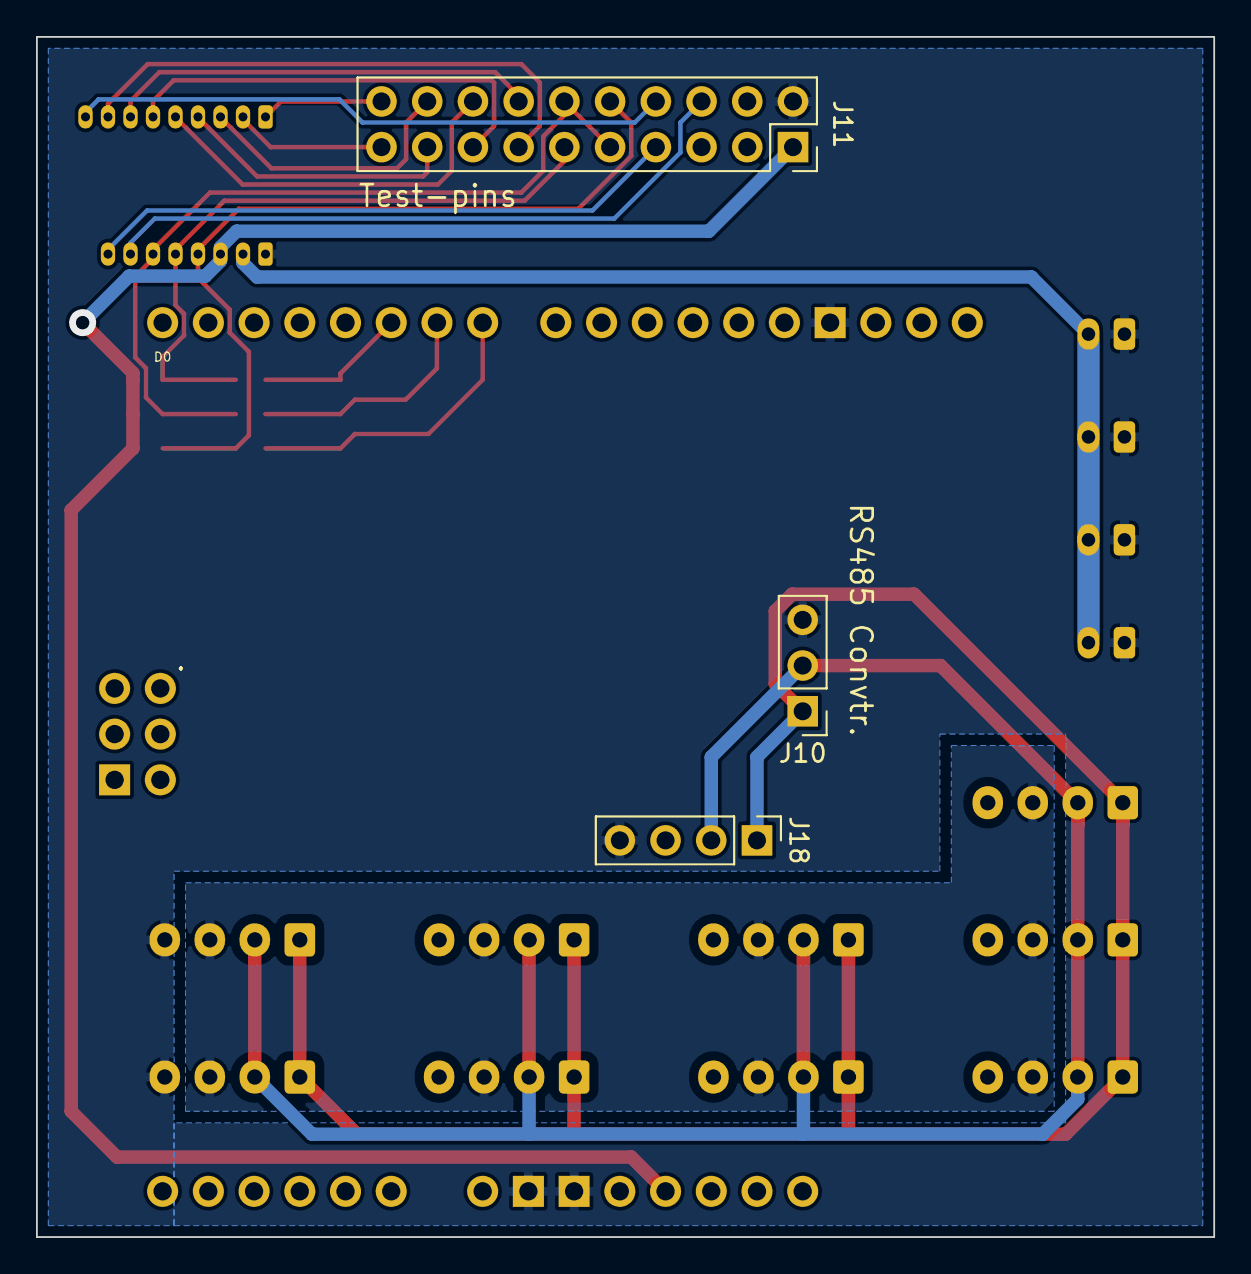
[picture p72: board NUcr.kicad_pcb from below]

Board: 2 copper layers, 65.4 x 66.7 mm, 28 parts (3 on the bottom side), 23 nets.
