NUbots/NUware/CameraSwitch/CameraSwitch.kicad_pcb

## KiCad design CameraSwitch/CameraSwitch.kicad_pcb (2017-06-02)

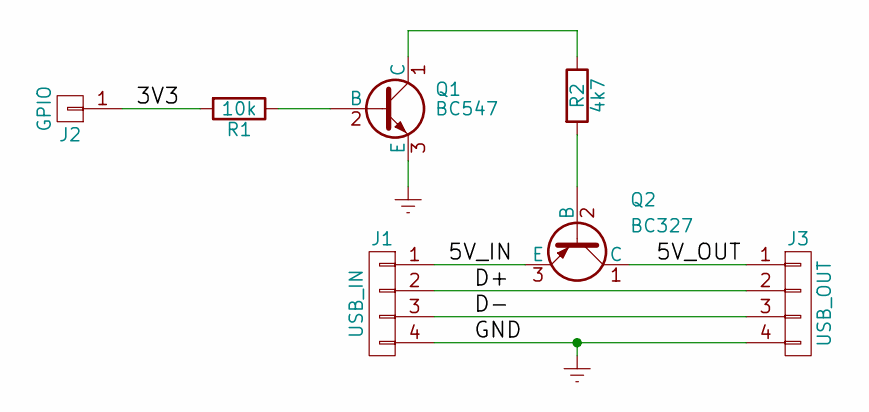
[picture p73: schematic CameraSwitch.sch, Camera Switch]

Parts:
4k7: R2; R_Axial_DIN0207_L6.3mm_D2.5mm_P10.16mm_Horizontal
J1: USB_IN; JST_XH_B04B-XH-A_04x2.50mm_Straight
J2: GPIO; PINTST
J3: USB_OUT; JST_XH_B04B-XH-A_04x2.50mm_Straight
Q1: BC547; TO-92_Molded_Narrow
Q2: BC327; TO-92_Molded_Narrow
R1: 10k; R_Axial_DIN0204_L3.6mm_D1.6mm_P1.90mm_Vertical

Connections:
/3V3: J2.1, R1.2
/5V_IN: J1.1, Q2.3 (E)
/5V_OUT: J3.1, Q2.1 (C)
/D+: J1.2, J3.2
/D-: J1.3, J3.3
Earth: J1.4, J3.4, Q1.3 (E)
unnamed: 4k7.1, Q1.1 (C)
unnamed: 4k7.2, Q2.2 (B)
unnamed: Q1.2 (B), R1.1

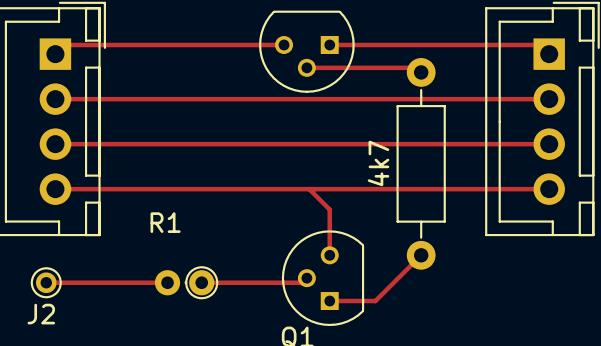
[picture p74: board CameraSwitch.kicad_pcb from above]

Board: 2 copper layers, 7 parts (0 on the bottom side), 9 nets.
