NUbots/NUware/NUcr/resources/SparkFun_USB_RS485_Converter.brd

## EAGLE design NUcr/resources/SparkFun_USB_RS485_Converter.brd (2025-03-18)

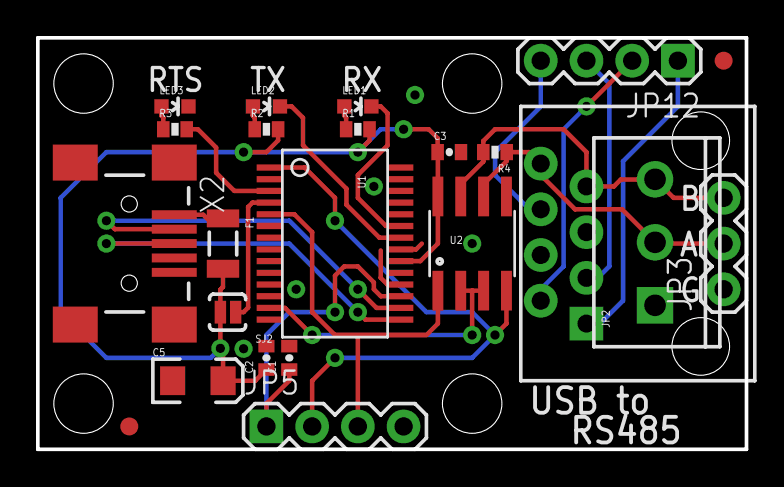
[picture p75: board SparkFun_USB_RS485_Converter.brd from above]

Board: 2 copper layers, 39.4 x 22.9 mm, 29 parts (1 on the bottom side), 22 nets.

Parts:
C1, C2, C3: 0.1uF; 0402-CAP
C5: 10uF; EIA3216
F1: 500mA; PTC-1206
JP1, JP6, JP7, JP8: STAND-OFF
JP2: SCREWTERMINAL-3.5MM-3
JP3: 1X03
JP4: RJ45-8PTH; RJ45-8
JP5: 1X04
JP9, JP10: FIDUCIAL1X2; FIDUCIAL-1X2
JP12: Unused Pins; 1X04
LED1: Red; LED-0603
LED2, LED3: Green; LED-0603
R1, R2, R3: 330; 0402-RES
R4: 220; 0402-RES
SJ2: SOLDERJUMPERNC2; SJ_2S-NOTRACE
U1: FT232R; SSOP28DB
U2: RS485; SO08
U$1: CREATIVE_COMMONS
U$2: LOGO-SFENEW; SFE-NEW-WEBLOGO
X2: USBSMD; USB-MINIB

Connections:
3.3V: C1.1, JP5.1, U1.17
A: JP2.2, JP3.2, JP4.8, R4.1, U2.6
B: JP2.3, JP3.3, JP4.7, R4.2, U2.7
GND: C1.2, C2.2, C3.2, C5.C, JP2.1, JP3.1, JP4.4, JP4.5, JP5.4, LED3.C, U1.7, U1.18, U1.21, U1.25, U1.26, U2.5, X2.GND
unnamed: LED1.A, R1.1
unnamed: LED2.A, R2.1
unnamed: F1.1, X2.VBUS
unnamed: LED3.A, R3.1
unnamed: JP4.1, JP12.1
unnamed: JP4.2, JP12.2
unnamed: JP4.3, JP12.3
unnamed: JP4.6, JP12.4
RTS: R3.2, U1.3
RX-I: JP5.3, U1.5, U2.1
RXLED: LED2.C, U1.22
TX-O: JP5.2, U1.1, U2.4
TXDEN: U1.13, U2.2, U2.3
TXLED: LED1.C, U1.23
USB_D+: U1.15, X2.D+
USB_D-: U1.16, X2.D-
VCC: C2.1, C3.1, C5.A, F1.2, R1.2, R2.2, SJ2.2, U1.20, U2.8
VCCIO: SJ2.1, U1.4
