NUbots/NUware/NUsense/Components/MPU Sensor.sch

## KiCad design NUsense/Components/MPU Sensor.sch (2018-01-29)

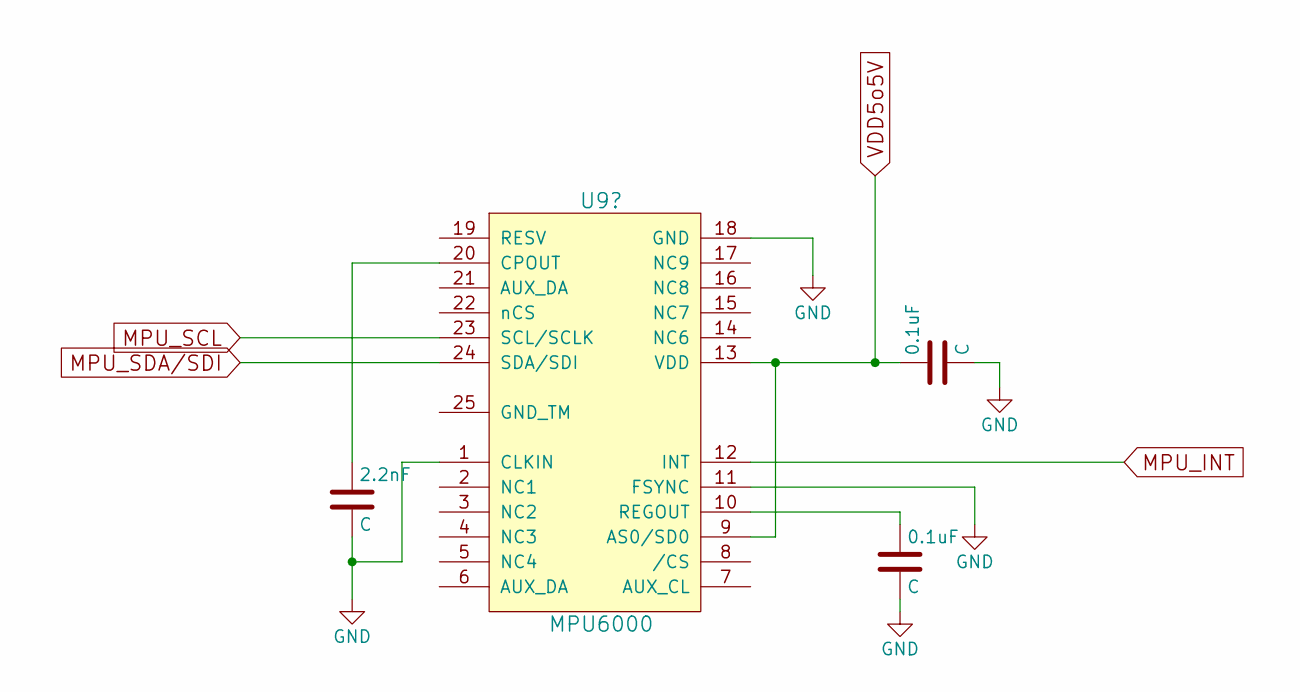
[picture p76: schematic MPU Sensor.sch]

Parts:
0.1uF, 2.2nF: C

Connections:
GND: 0.1uF.2, 2.2nF.2
VDD5o5V: 0.1uF.1
