NUbots/NUware/NUFSR/Core/Inc/main.h

#define XTAL_32MHZ_IN_Pin GPIO_PIN_0
#define XTAL_32MHZ_IN_GPIO_Port GPIOF
#define XTAL_32MHZ_OUT_Pin GPIO_PIN_1
#define XTAL_32MHZ_OUT_GPIO_Port GPIOF
#define FSR1_Pin GPIO_PIN_0
#define FSR1_GPIO_Port GPIOA
#define FSR2_Pin GPIO_PIN_1
#define FSR2_GPIO_Port GPIOA
#define FSR3_Pin GPIO_PIN_2
#define FSR3_GPIO_Port GPIOA
#define FSR4_Pin GPIO_PIN_3
#define FSR4_GPIO_Port GPIOA
#define MPU_INT_Pin GPIO_PIN_8
#define MPU_INT_GPIO_Port GPIOD
#define MPU_INT_EXTI_IRQn EXTI9_5_IRQn
#define MPU_NSS_Pin GPIO_PIN_6
#define MPU_NSS_GPIO_Port GPIOC
#define MPU_CLK_Pin GPIO_PIN_7
#define MPU_CLK_GPIO_Port GPIOC
#define MPU_MISO_Pin GPIO_PIN_8
#define MPU_MISO_GPIO_Port GPIOC
#define MPU_MOSI_Pin GPIO_PIN_9
#define MPU_MOSI_GPIO_Port GPIOC
#define DXL_DIR_Pin GPIO_PIN_8
#define DXL_DIR_GPIO_Port GPIOA
#define DXL_P_Pin GPIO_PIN_9
#define DXL_P_GPIO_Port GPIOA
#define DXL_N_Pin GPIO_PIN_10
#define DXL_N_GPIO_Port GPIOA
#define JTAG_TMS_Pin GPIO_PIN_13
#define JTAG_TMS_GPIO_Port GPIOA
#define JTAG_TCK_Pin GPIO_PIN_14
#define JTAG_TCK_GPIO_Port GPIOA
#define JTAG_TDI_Pin GPIO_PIN_15
#define JTAG_TDI_GPIO_Port GPIOA
#define JTAG_TDO_Pin GPIO_PIN_3
#define JTAG_TDO_GPIO_Port GPIOB
#define JTAG_RST_Pin GPIO_PIN_4
#define JTAG_RST_GPIO_Port GPIOB
#define LED1_Pin GPIO_PIN_8
#define LED1_GPIO_Port GPIOB
#define LED2_Pin GPIO_PIN_9
#define LED2_GPIO_Port GPIOB
