NUbots/NUware/(commit log)

2017-06-02 Adds the USB Camera Switch kicad design files.
    [CameraSwitch.kicad_pcb, CameraSwitch.sch]
2017-06-02 Adds the Power Board altium design files.
    [PowerBoard.PcbDoc, PowerBoard.PrjPcb, PowerBoard.SchDoc]
2017-06-25 Igus design files
    [Ankle Cover Left Original.step, Ankle Cover Left V2.0.step, Ankle Cover Left V2.0.stl, Ankle Cover Right Original.step, Ankle Cover Right V2.0.step, Ankle Cover Right V2.0.stl, Arm Lower Cover Left Original.step, Arm Lower Cover Right Original.step]
2017-06-26 Rearranged files and added a readme for the igus files.
    [Ankle Cover Left Original.step, Ankle Cover Left V2.0.step, Ankle Cover Left V2.0.stl, Ankle Cover Right Original.step, Ankle Cover Right V2.0.step, Ankle Cover Right V2.0.stl, Arm Lower Cover Left Original.step, Arm Lower Cover Right Original.step]
2018-01-31 Correct broken files
    [MCU Unit.sch, MCU.sch, MPU Sensor.sch, NUsense.kicad_pcb, NUsense.sch, OTG-HS USB2o0.sch, Power.sch, RS485.sch]
2018-09-28 Decimate skins
    [Torso.stl, leg_lower_left.stl, servo_block.stl]
2018-10-19 Update igus step files
    [Ankle Cover Left V2.0.step, Ankle Cover Left V2.0.stl, Ankle Cover Right V2.0.step, Ankle Cover Right V2.0.stl, Ankle_cover_left v4.step, Ankle_cover_right v4.step, Arm Lower Inside Left V2.0.stl, Arm Lower Inside Right V2.0.stl]
2018-10-19 Don't look
    [Ankle Cover Left V2.0.step, Ankle Cover Right V2.0.step, Battery Cover Back Plate V2.0.step, CM730 Shelf V2.0.step, Foot Cover Plate V2.0.step, Foot Heel Cover V2.0.step, Foot Left V2.0.step, Foot Top Cover Left V2.0.step]
2019-04-18 Updates 3d model files
    [Ankle Cover Left V2.0.stl, Ankle Cover Right V2.0.stl, Ankle_Block_v4.step, Ankle_cover_left v4.step, Ankle_cover_left.stl, Ankle_cover_right v4.step, Arm Lower Inside Left V2.0.stl, Arm Lower Inside Right V2.0.stl]
2019-04-30 Removes duplicate files
    [Ankle_cover_left.stl, Arm_Lower_Inside_Right_V2.stl, Arm_Lower_Outside_Left.stl, Arm_Upper_Left_v1_(2).stl, Arm_lower_bar.stl, Battery.stl, Battery_Cover_Back_Plate_V2.stl, Body_Back_Top_Cover_Plate_v10_(1)_(1)_(1).stl]
2019-09-28 Add custom brackets and cable clamps
    [Cable_Holder.step, Cable_Holder.stl, Flywheel_Bracket.step, Flywheel_Bracket.stl, Head_Bracket.step, Head_Bracket.stl]
2019-09-28 Move new files to correct location
    [Cable_Holder.step, Cable_Holder.stl, Flywheel_Bracket.step, Flywheel_Bracket.stl, Head_Bracket.step, Head_Bracket.stl]
2019-09-28 Add knee servo cable holder
    [Servo_cable_holder.stl]
2019-11-25 Add NUFSR files
    [nufsr-controller.schdoc, nufsr-fsr.schdoc, nufsr-motion-sensor.schdoc, nufsr-p00.PrjPcb, nufsr-power-decoupling.schdoc, nufsr-power.schdoc, nufsr-rs485.schdoc, nufsr-user-io.schdoc]
2021-01-03 Added STM32CubeMX Workspace files.
    Got UART transmission/receive coms working using Interrupts. In addition, the NUFRSR.ioc file has been updated to correctly match the NUfsr board schematics.
    [NUFSR.ioc, main.h]
2021-01-07 Error checking & comment tidy for USART files
    Tidied code/comments and removed unused variables and includes.
    [usart.c, usart.h]
2021-01-22 Updated .ioc configuration file & Defines for IMU.
    1. .ioc config file updates for SPI to IMU communication settings
    2. #define implemented for all IMU address commands
    3. Still need to implement data defines for IMU commands
2021-02-05 Changes to imu.h, and main.c for debugging
2021-02-28 Implemented IMU.c for custom functions. Added init settings.
    Implemented a source file the IMU. Created simple transfer functions that will help speed up further debugging.
2021-07-19 STM32CubeIDE Files
    Added files for STM32CubeIDE Development
2025-03-18 Add the NUcr files for posterity. (#5)
    * First commit.
    * Added documentation.
    * Add further documentation.
    [NUcr-B_Cu.gbl, NUcr-B_Mask.gbs, NUcr-B_Paste.gbp, NUcr-B_Silkscreen.gbo, NUcr-Edge_Cuts.gm1, NUcr-F_Cu.gtl, NUcr-F_Mask.gts, NUcr-F_Paste.gtp]
2025-04-24 Redesign of Back Panel I/O PCB (#6)
    * Redesigned the PCB for the back-panel IO.
    * Made the gitignore more consistent.
    * Widened the gitignore's scope.
    * I don't know what this is.
    * Tidied up some designators; moved two traces on the top layer to pass
    DRC.
    * Added colours to the schematic.
    * Fixed the imported switch component.
    * Added a readme file; added part numbers to the schematic.
    * Added three debouncing capacitors.
    * Generated Gerber files for JLCPCB.
    * Added PDFs for easy reading on the GitHub website.
    * Added screenshots and a BoM from DigiKey.
    * I really must stop making more commits.
    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
    [PCB_BackDesign-B_Cu.gbl, PCB_BackDesign-B_Mask.gbs, PCB_BackDesign-B_Paste.gbp, PCB_BackDesign-B_Silkscreen.gbo, PCB_BackDesign-Edge_Cuts.gm1, PCB_BackDesign-F_Cu.gtl, PCB_BackDesign-F_Mask.gts, PCB_BackDesign-F_Paste.gtp]
2026-06-12 Added the gerbers for this PCB (#7)
