NUbots/NUware/(notices)

Notices in the files:
NUFSR/Core/Inc/main.h:
© Copyright (c) 2020 STMicroelectronics.
All rights reserved.
parts and their libraries:
SparkFun: Released under the Creative Commons Attribution Share-Alike 3.0 License
